Balvinder123x/ivflow-pcb/docs/stage4_render_top.png

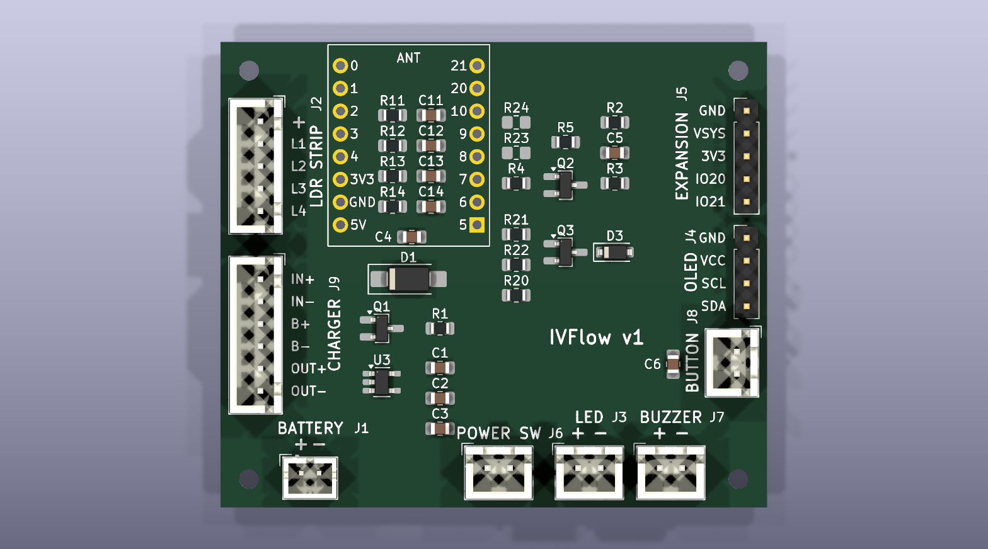
docs/stage4_render_top.png
