Balvinder123x/ivflow-pcb/docs/compact_render_top.png

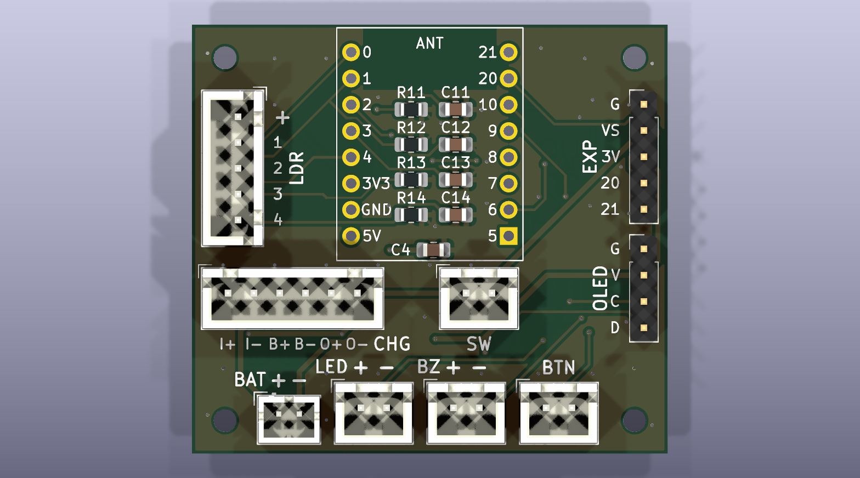
docs/compact_render_top.png
