Balvinder123x/ivflow-pcb/PROGRESS.md

# IVFlow PCB — Progress

## Environment (checked 2026-10-31)
| Item | Found |
|---|---|
| KiCad | 10.0.8, `C:\Program Files\KiCad\10.0` |
| kicad-cli | `C:\Program Files\KiCad\10.0\bin\kicad-cli.exe` (not on PATH; scripts use full path) |
| KiCad Python | `C:\Program Files\KiCad\10.0\bin\python.exe` — Python 3.11.5, `pcbnew` 10.0.8 |
| kiutils | 1.4.8, `pip --user` into KiCad's Python |
| git | 2.56.0, `C:\Program Files\Git\cmd\git.exe`; repo identity Balvinder123x <balvinder23166@iiitd.ac.in> |
| Java | Temurin 21.0.13 JRE, `C:\Program Files\Eclipse Adoptium\jre-21.0.13.9-hotspot\bin\java.exe` |
| Freerouting | 2.5.0 official jar in `tools/freerouting/` (git-ignored), run on a portable Temurin 25.0.5 JRE in `tools/jre25/` (SHA-256 verified; the jar needs Java 25). The native `freerouting-cli` 2.5.0 build crashed (GraalVM serialization error) and was removed. |

### Tooling rules
kiutils 1.4.8 predates the KiCad 10 format and drops data when rewriting KiCad 10 files.
- Symbols: generated with kiutils, then normalised with `kicad-cli sym upgrade --force`.
- Footprints: generated with the `pcbnew` API (writes native KiCad 10 format directly).
- Never rewrite a file KiCad/the user has saved with kiutils.
- Schematic: generated by `scripts/make_schematic.py` with `scripts/kisexpr.py` (lossless
  S-expression reader/writer; official symbols are embedded flattened). The script verifies
  every pin against KiCad's exported netlist, then runs ERC.
- Previews: `kicad-cli sym/fp/sch export svg`, rasterised with headless Edge for checking.

### Library availability (official KiCad 10 libs)
All needed parts exist **except** `Transistor_FET:DMG2305UX` → Q1 = **AO3401A**.

## Design changes vs. original spec
- 2026-10-31: off-board parts plug in through connectors.
  - J_OLED: 1×4 male header, fixed order GND, VCC, SCL, SDA (jumper wires to module) → no custom part.
  - LED: D2 replaced by **J_LED** (JST-XH 2-pin, pin 1 = anode/+, pin 2 = cathode/−). R20 stays on board.
  - J_LDR unchanged (JST-XH 5-pin).
- 2026-11-01: power switch, buzzer and button also moved off-board (user decision):
  SW1 → **J6 POWER SW** (1 VSYS, 2 VSYS_SW, to a panel-mount switch ≥ 1 A),
  BZ1 → **J7 BUZZER** (1 + VSYS_SW, 2 − BUZ_N), SW2 → **J8 BUTTON** (1 BTN, 2 GND).
  All JST-XH 2-pin. D3 (flyback) and C6 (debounce) stay on the board.
  ⚠ J3/J6/J7/J8 are identical, so cables can be swapped. Most swaps are harmless, but the
  switch or button cable in J7 shorts VSYS_SW to GND through Q3 when the buzzer turns on,
  and the LED in J7 has no series resistor. User chose clear silkscreen labels (2026-11-01);
  a 3-pin keyed J6 is still possible if wanted.
- 2026-11-01: **TP4056 moved off-board** (user decision, so the PCB doesn't wait for the module
  to arrive; online pad layouts differ between sellers, lengths 22–29 mm). New **J9 CHARGER**,
  JST-XH 6-pin: 1 IN+ (VBUS), 2 IN− (GND), 3 B+ (BATT+), 4 B− (BATT−), 5 OUT+ (VBAT_P),
  6 OUT− (GND). U2 kept in schematic + BOM, `on_board no`, no footprint. The TP4056
  placeholder footprint was deleted. The user solders a 6-pin XH cable to the module's pads.
  Current through J9 ≤ ~1.3 A (1 A charge + load); XH is rated 3 A.
- 2026-11-01: SuperMini footprint from **published dimensions** (user decision; no source gives
  the first-pin offset → pins centred). Check the real board on a 1:1 printout before ordering.
- Reference designators: KiCad treats references without a number as unannotated, so the
  spec's connector names map to numbered refs (the Value field carries the name):
  J1 = J_BAT (BATTERY), J2 = J_LDR (LDR STRIP), J3 = J_LED (LED), J4 = J_OLED (OLED),
  J5 = J_EXP (EXPANSION), J6 POWER SW, J7 BUZZER, J8 BUTTON, J9 CHARGER. Power flag = #FLG01.
- Net names used for internal nodes: LED_EN (GPIO5), BUZ_EN (GPIO6), BAT_EN (GPIO7), BTN (GPIO10),
  EXP_IO20/21, LED_A, BUZ_N (buzzer −), Q2_D, Q2_G, Q3_G, BATT+/BATT− (battery side of U2).

## Stages
- [x] **0. Environment + skeleton** — approved, committed
- [x] **1. Custom library** — approved 2026-11-02
  - `scripts/make_library.py` generates `ivflow/ivflow_lib/`
  - Symbol `ESP32-C3_SuperMini` ✔ — pin order **confirmed** from the user's board diagram (2026-10-31):
    top view, USB up: left row GPIO5,6,7,8,9,10,20,21 (pads 1-8); right row 5V, GND, 3V3,
    GPIO4,3,2,1,0 (pads 9-16). Antenna at the end opposite USB.
  - Footprint `ESP32-C3_SuperMini` — published dimensions 22.52 × 18 mm; row spacing 15.24 mm
    (also confirmed by the user's breadboard count); USB-C overhang ~2 mm (user, in courtyard);
    pins assumed centred (no source gives the offset). Marked "PUBLISHED DIMS – check on arrival"
    on F.Fab. **Before ordering the PCB: print the board 1:1 and lay the real SuperMini on it.**
    Courtyard = the two socket strips only (module stands ~8.5 mm up, low SMD parts may sit
    underneath); antenna keepout also forbids footprints. Pin names 1.0 mm, centred (2026-11-02).
  - Symbol `TP4056_Module_USB-C` ✔ (pads 1 IN+, 2 IN−, 3 BAT+, 4 BAT−, 5 OUT+, 6 OUT−), no
    footprint (module is off-board on J9).
- [x] **2. Schematic + ERC** — approved 2026-11-01 (connector polarities checked by the user)
  - One A4 sheet, blocks: Power, MCU, Battery sense, Sensors, LED, Buzzer, OLED/Button/Expansion
  - Netlist check: all 116 pin connections match the spec (with J9, 2026-11-01)
  - ERC: 0 errors, 0 warnings
- [x] **3. Footprints + BOM** — approved 2026-11-02
  - Footprints + `LCSC` field set per part in `scripts/make_schematic.py` (schematic regenerated;
    it had not been edited in KiCad). Hand-soldering pad variants for 0805 / SOT-23 / SOT-23-5 / SMA.
  - Connectors: J1 JST-PH B2B-PH-K; J2 JST-XH B5B-XH-A; J3, J6, J7, J8 JST-XH B2B-XH-A;
    J9 JST-XH B6B-XH-A (C144397); J4, J5 2.54 mm pin headers.
  - `scripts/make_bom.py` → `ivflow/bom/ivflow_bom.csv` (26 lines, 41 parts, exported from the
    schematic by kicad-cli) and `ivflow/bom/ivflow_offboard.csv` (things plugged into connectors,
    housings, hardware). Re-run it after any schematic edit.
  - All LCSC numbers checked against lcsc.com product pages. No number for J4/J5 (generic headers),
    U1/U2 (modules).
  - Footprint check: every on-board part has an existing footprint.
  - ERC: 0 errors, 0 warnings.
  - From Stage 4 on, symbol UUIDs link schematic ↔ board: the schematic must NOT be regenerated
    after the board is populated — targeted edits only.
  - Connector silkscreen labels defined in `scripts/silk_labels.py` (title naming the part that
    plugs in + a label per pin, "+"/"−" drawn large). Added to each footprint in Stage 4 so they
    move with the connector. Preview: `docs/connector_labels.png`.
- [x] **4. Outline, holes, placement** — approved 2026-11-02
  - `scripts/make_board.py` builds `ivflow.kicad_pcb` from kicad-cli's netlist export of the
    schematic (footprints, values, nets, symbol UUID links, fields). Placement table `PLACE`
    in the script. Refuses to overwrite a populated board without `--force`.
  - Board 61 × 52 mm, 4 × M2 holes (MountingHole_2.2mm_M2, NPTH) 3.2 mm from the corners,
    "IVFlow v1" on silk. Connector labels from `scripts/silk_labels.py` (reference printed
    after each title).
  - U1 turned 180°: antenna at the top edge over its keepout; USB-C points into the board and
    the strip below it holds only SMD parts, so a cable still fits with the module plugged in.
  - Under the module: LDR filters R11–R14/C11–C14 next to GPIO0–4, and C4.
  - Rules in `ivflow.kicad_pro` (JLCPCB 2-layer): clearance/track min 0.127, via min
    0.5/0.3, copper-to-edge 0.3, hole-to-hole 0.5, silk text ≥ 1.0/0.15 mm. Net classes:
    Default 0.25 mm, Power 0.5 mm (VBUS, VBAT_P, VSYS, VSYS_SW, +3V3, BATT+, BATT−).
  - DRC (`--schematic-parity`): 0 violations, 0 footprint errors, 84 unconnected pads
    (expected: no tracks until Stage 5). ERC still 0/0.
  - Previews: `docs/stage4_render_top.png` (3D), `docs/stage4_placement.png` (ratsnest).
  - From now on the board and schematic are linked by UUID: no regeneration of either,
    targeted edits only (once the user edits the board in KiCad).
- [x] **5. Routing + pours + DRC** — approved 2026-11-03
  - `scripts/route_board.py`: Specctra DSN export → Freerouting (100 passes max) → session
    import → GND zones on F.Cu and B.Cu (clearance 0.3, min width 0.25, thermal reliefs) →
    94 GND stitching vias on a 5 mm grid, each placed only where both pours are solid → refill.
  - Freerouting: 84 nets, 100 % routed in 3 passes, 0 violations. 14 signal vias.
  - Widths: power nets 0.5 mm (necked to 0.375 mm only at SOT-23 pads), signals 0.25 mm
    (0.187 mm at a few pin escapes). All above JLCPCB's 0.127 mm.
  - Antenna area checked: no copper fill, tracks or vias on either layer.
  - DRC (`--schematic-parity`): **0 violations, 0 unconnected pads, 0 footprint errors**.
    ERC 0/0.
  - Previews: `docs/stage5_routing_front.png`, `docs/stage5_routing_back.png` (tracks without
    pour), `docs/stage5_render_top.png`, `docs/stage5_render_bottom.png`.
- [ ] **6. Fab outputs** — done, 🛑 waiting for review (2026-11-03)
  - `scripts/make_fab.py` → `fab/` (see `fab/README.md`). Runs ERC + DRC first and stops
    unless both are clean (ERC 0/0, DRC 0 violations / 0 unconnected / 0 footprint errors).
  - Gerbers: F/B Cu, Paste, Silkscreen, Mask, Edge.Cuts; Protel extensions, no X2, soldermask
    subtracted from silk. Drill: Excellon mm, PTH and NPTH separate, Gerber X2 drill maps.
    Zipped as `fab/ivflow_gerbers_jlcpcb.zip` (14 files). Job file: 61.1 × 52.1 mm, 2 layers, 1.6 mm.
  - BOM: JLCPCB format (24 lines, DNP + off-board excluded) and full BOM (26 lines).
  - CPL: 38 parts (JLCPCB rotations not corrected; only matters for JLCPCB assembly).
  - Schematic PDF, 1:1 assembly drawing PDF, 3D renders top/bottom.
  - **Before ordering:** print the 1:1 PDF at 100 % and check the real SuperMini.
- [ ] **v1 compact revision** — done, 🛑 waiting for review (2026-11-05)
  - User request: smallest possible board, short recognisable labels.
  - R23/R24 (DNP I2C pull-ups) removed from the schematic (OLED module has them). Netlist
    check 112/112, ERC 0/0. C11–C14, C4 and J5 kept (user choice).
  - Board **46 × 41.5 mm** (was 61 × 52, −40 % area), parts on both sides (user choice):
    top = SuperMini, all connectors, LDR filters + C4 under the module; bottom = power path +
    regulator (strip between the two connector rows), battery sense (under the module),
    button cap / buzzer driver / LED resistor (right of the module). 4 × M2 corner holes kept.
  - The USB-C plug path under the SuperMini is no longer kept free (connectors sit below it):
    lift the module off its sockets to program it over USB.
  - Silk labels: one short name + pin marks per connector — BAT + −, LDR + 1 2 3 4, LED + −,
    BZ + −, BTN, SW, CHG I+ I− B+ B− O+ O−, OLED G V C D, EXP G VS 3V 20 21. J-numbers moved
    to the fab layer (assembly drawing). "IVFlow v1" on the bottom silk.
  - Rule `min_resolved_spokes` = 1 (two crowded THT GND pins get one thermal spoke on top; they
    also join the bottom pour).
  - Routed with Freerouting, GND pours + stitching vias. DRC 0 violations / 0 unconnected /
    0 footprint errors. Fab outputs regenerated.
  - Script fixes: footprints are loaded through one explicit PCB_IO plugin, and old items are
    removed with `board.Delete()` (`Remove()` broke pcbnew's SWIG types).
- [ ] **Enclosure v1** (Fusion 360, `mech/fusion_enclosure.py`), 2026-11-05: first working
  layout, 0 interferences. Problem found: the LED/LDR pockets faced closed wiring bays, so
  they could not be fitted. Superseded by v2.
- [ ] **Enclosure v2** — done, 🛑 waiting for review (2026-11-05)
  - `mech/fusion_enclosure_v2.py` builds the Fusion document "IVFlow enclosure v2" through
    `scripts/fusion_mcp.py` (direct HTTP to Fusion's MCP add-in; the VS Code extension does
    not load the server). Save the document in Fusion by hand (Ctrl+S).
  - Style from the user's inspiration: 54 × 146 mm, soft rounded front (R12, 3 mm edges),
    full smoked-acrylic face with the OLED behind it, flat-bottom notch at the top where the
    spike cap sits. User choices: no knob, no status LED, sensing zone closed (cap visible only).
  - Parts: black chassis (front + sensor head, one print: everything mounts in it), white back
    shell (4 × M2 through the PCB holes), black hinged door, 2 black side covers, 2 mm acrylic.
  - LED and LDRs go in **from the outside**: side recesses with flush covers, wire holes from
    the recesses down to the PCB. LDR slit now centred on the chamber axis (channel front is a
    U with 3.5 mm chamfers; the side foam centres the chamber).
  - TP4056 moved to the middle behind the battery (USB-C hole in the flat part of the bottom),
    battery 4 mm higher and PCB at z 36 because of the rounded bottom corners.
  - Check: 0 overlapping pairs among 56 bodies (incl. the real PCB STEP).
  - Pictures: `docs/enclosure_v2_*.png`.
  - Door lock + light seal (2026-11-05): snap latch on the free edge (flexible arm in a flush
    track on the right side, barb clicks into a notch, finger scoop to release; print the door
    in PETG, arm strain ~1.2 %), magnets kept. Light seal: tongue into the channel and into
    the backs of the fork and tube slots (right edges tapered for the swing), groove for black
    foam gasket tape beside the tongue. Swing test 0-90 deg: no collision except the barb's
    click at 1-2 deg.
  - Colour identity (user decision): matte pearl white body + black glossy acrylic face.
    White plastic leaks light, so the light-tightness comes from thick walls (head sides
    14 mm), the black foam lining, the tongue labyrinth and the gasket.
  - **Black sensor insert** (user request, replaces the side covers): the head is a pearl white
    shell (2.4 mm sides, 1.5 mm top/floor) around a black-printed insert that holds the whole
    light path (channel, fork/tube slots, LED hole, slit, LDR pocket, door magnet, middle hinge
    knuckle). LED + LDRs are fitted and wired on the bench, lead spaces filled with black hot
    glue, wires run down grooves in the insert and through the shell floor to J2/J3; the insert
    slides in from the back and is held by 2 x M2 x 8 from below. Sides are now plain white.
    Checks: 0 overlaps (55 bodies), door swing 0-90 deg clear of shell and insert, insert slides
    out 40 mm without collision. Recommended: black flocking tape or foam on the channel walls.

## Power-path / safety review (2026-11-01)
TP4056 is only a charger; the board adds the rest:
- Load sharing: with USB present the system runs from VBUS through D1 and Q1 is off
  (gate = VBUS), so the TP4056 charges the battery only and terminates correctly. Without USB,
  R1 pulls Q1's gate low and the battery feeds VSYS through Q1.
- Battery protection: DW01A + 8205A on the module (over-discharge ~2.4 V, over-current, short);
  the board takes power from the protected OUT+/OUT−, and BAT− never touches GND.
- Firmware must add a low-battery shutdown (≈3.3–3.4 V via BAT_SENSE): DW01A's cut-off is too
  deep for Li-Po life, and AP2112K drops out below ≈3.5 V input at full load.

## Drop sensing notes (2026-11-03)
- Concept validated by DripOMeter (open-source, HardwareX 2022, PMC9418544): green LED + LDR
  voltage divider across the drip chamber, works in room light with a slit mask in the sensor
  holder, dynamic baseline (1 Hz low-pass) + threshold to detect each drop. Same as IVFlow.
- Tune on a breadboard before fixing values: R11–R14 (DripOMeter matched the series resistor to
  the LDR's dark resistance). If R11–R14 go large (100k–1M), reduce C11–C14 (1 nF or DNP):
  10 nF × large R would slow the signal further (the LDR itself already takes ~20–30 ms).
- Fallback if the dip is too weak: IR LED + phototransistors on the same J2/J3 (R20 → ~150 Ω).

## Open questions
None blocking. When the parts arrive (before ordering the PCB):
1. Print `fab/ivflow_assembly_top_1to1.pdf` at 100 % (outline must measure 61 × 52 mm) and
   check the SuperMini's pins line up with U1 (pins-centred assumption).
2. Check the battery plug is JST-PH 2.0 with red = pin 1, and the OLED pin order.

Resolved 2026-11-01: power switch → J6 connector; buzzer + button → J7/J8 connectors;
mis-plug risk handled with clear silk labels; repo pushed to
https://github.com/Balvinder123x/ivflow-pcb (remote `origin`, push after every stage commit).
