Balvinder123x/ivflow-pcb/docs/compact_render_bottom.png

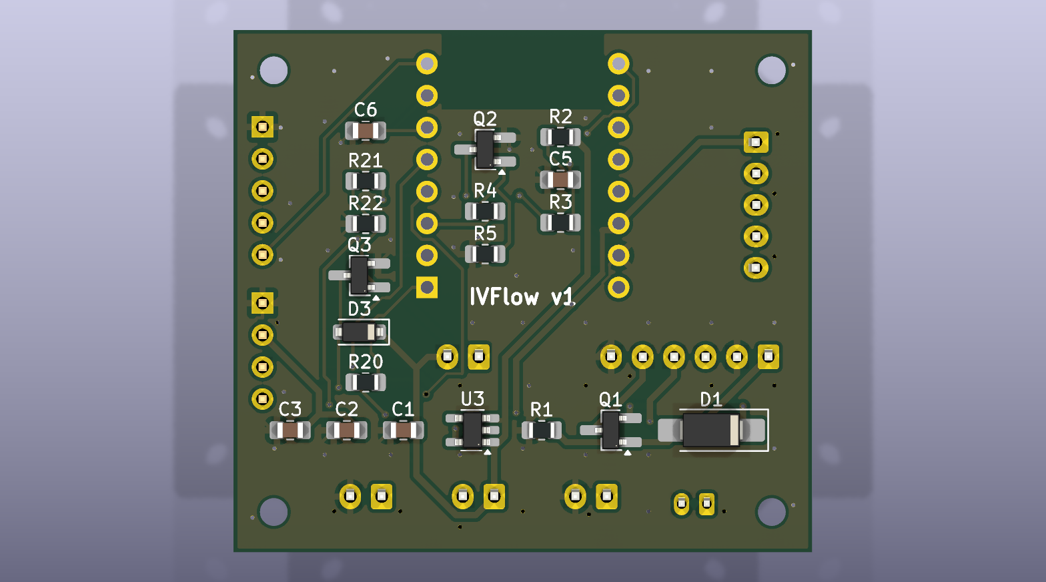
docs/compact_render_bottom.png
