Balvinder123x/ivflow-pcb/docs/connector_labels.png

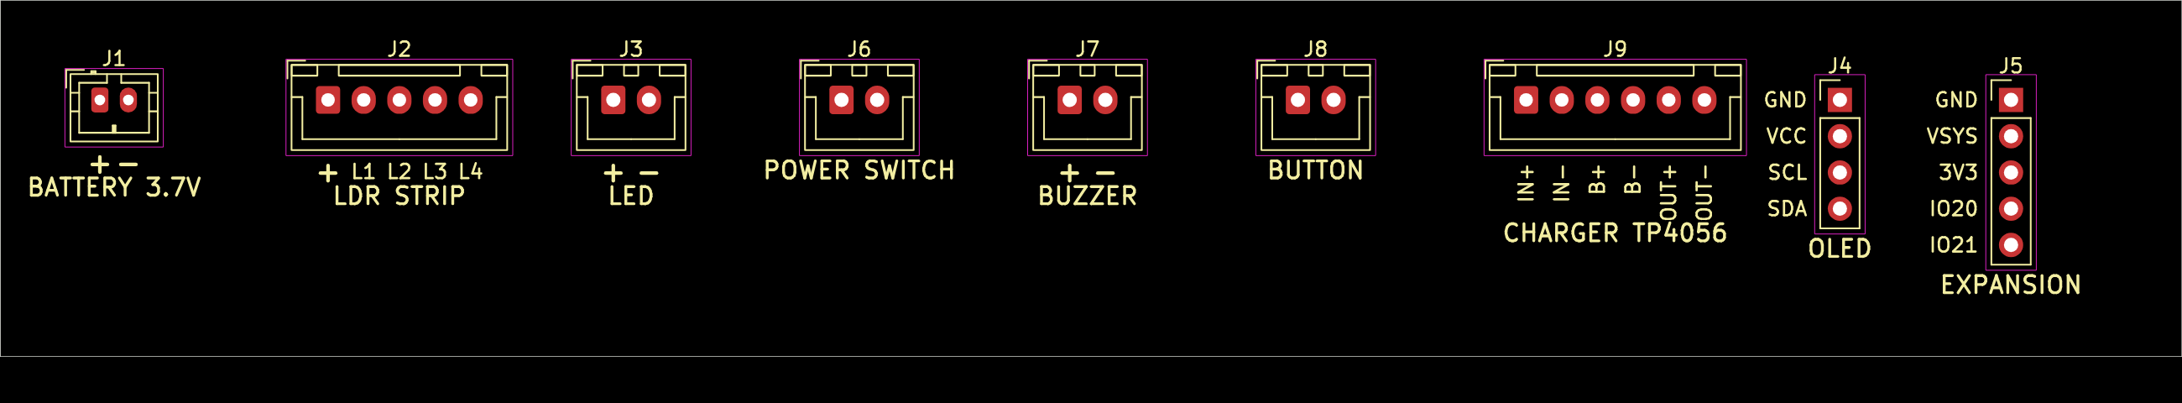
docs/connector_labels.png
