Balvinder123x/ivflow-pcb/docs/enclosure_v1_front.png

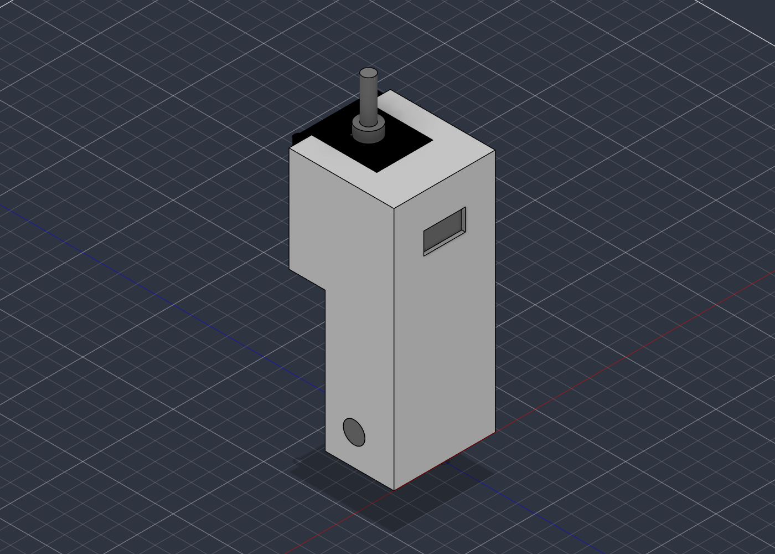
docs/enclosure_v1_front.png
