Balvinder123x/ivflow-pcb/docs/enclosure_v1_inside.png

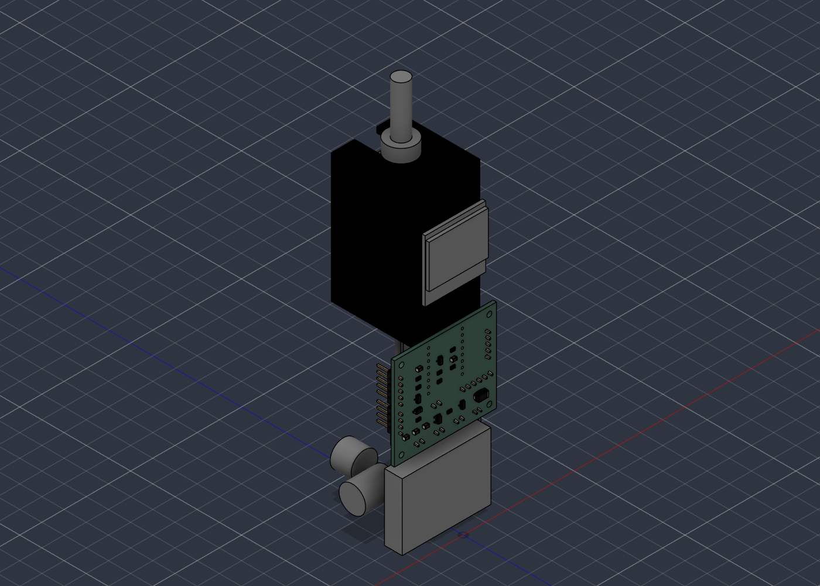
docs/enclosure_v1_inside.png
