Balvinder123x/ivflow-pcb/docs/enclosure_v1_side.png

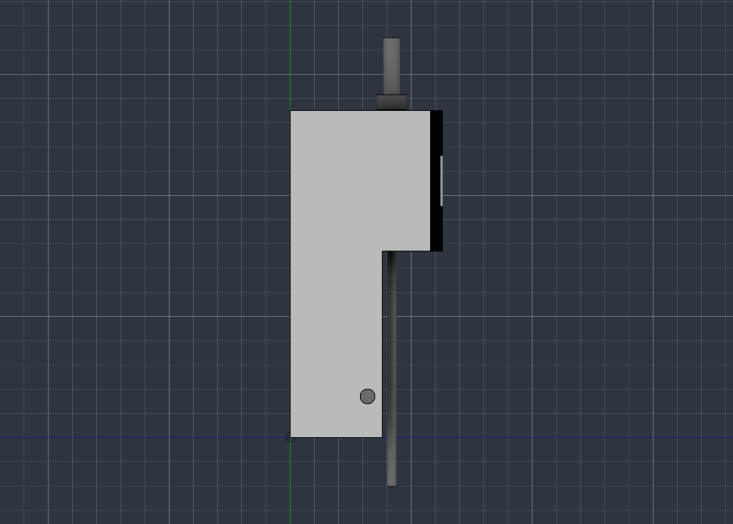
docs/enclosure_v1_side.png
