Balvinder123x/ivflow-pcb/docs/enclosure_v2_front.png

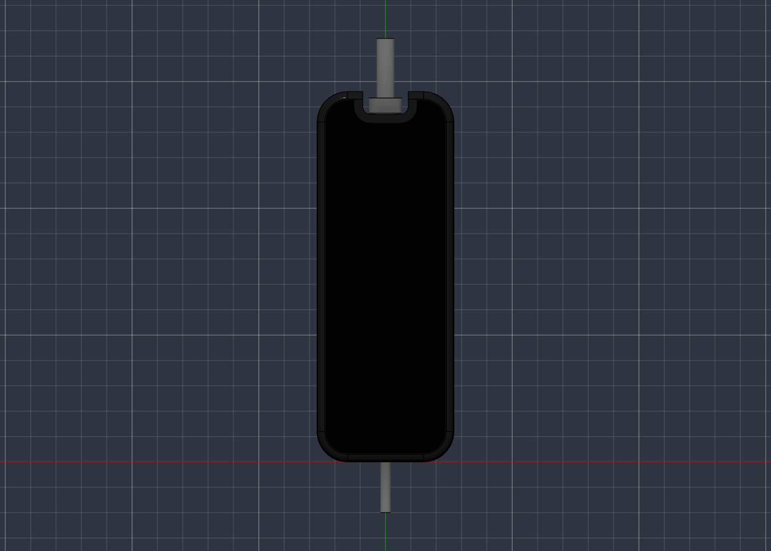
docs/enclosure_v2_front.png
