Balvinder123x/ivflow-pcb/docs/enclosure_v2_insert_alone.png

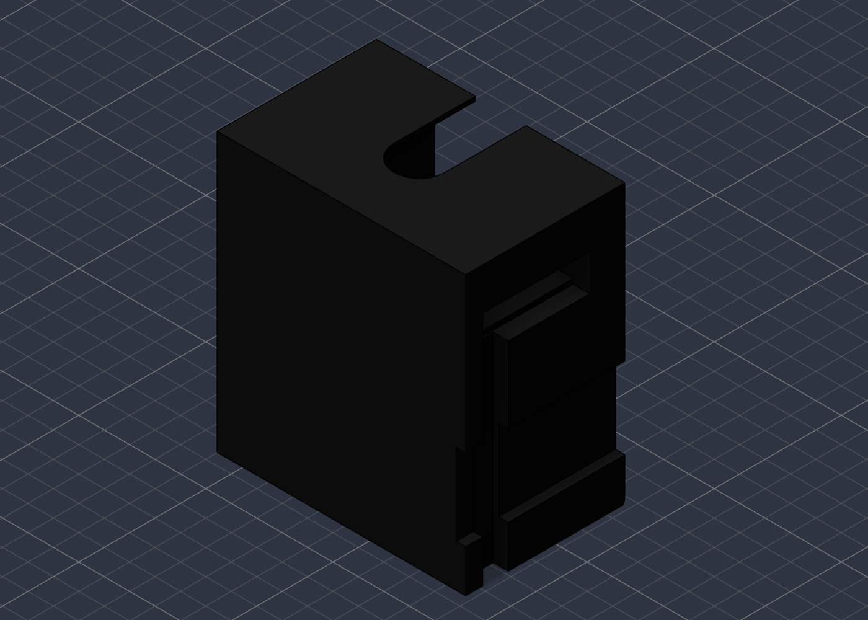
docs/enclosure_v2_insert_alone.png
