Balvinder123x/ivflow-pcb/docs/enclosure_v2_insert_back_door_off.png

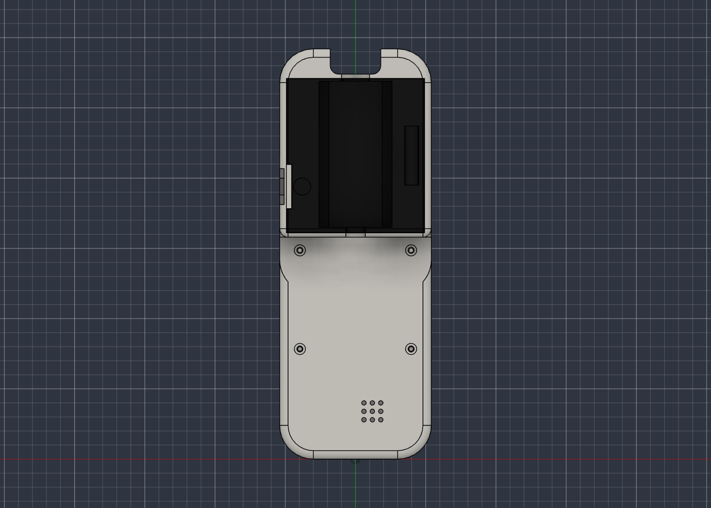
docs/enclosure_v2_insert_back_door_off.png
