Balvinder123x/ivflow-pcb/docs/enclosure_v2_inside_back.png

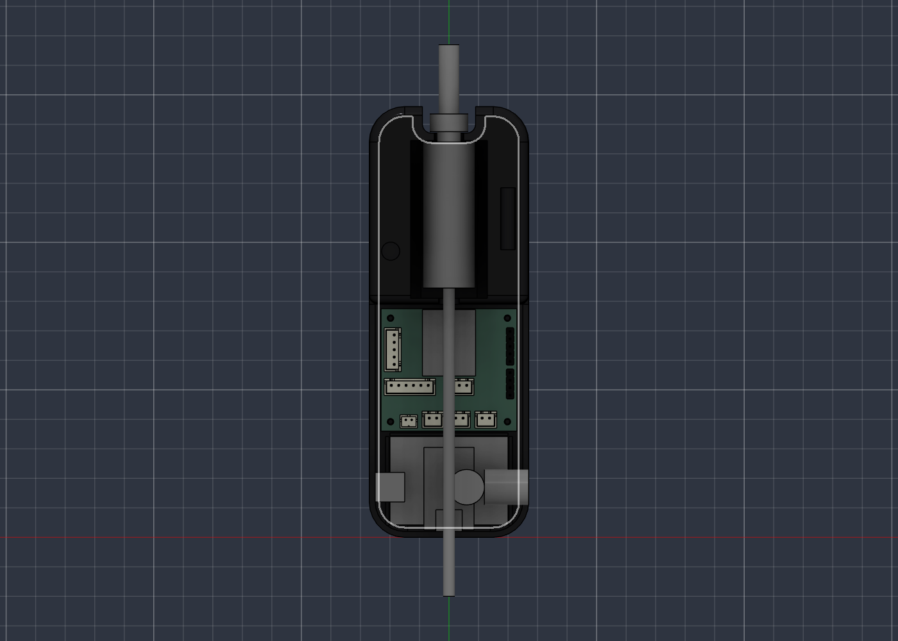
docs/enclosure_v2_inside_back.png
