Balvinder123x/ivflow-pcb/docs/enclosure_v2_iso.png

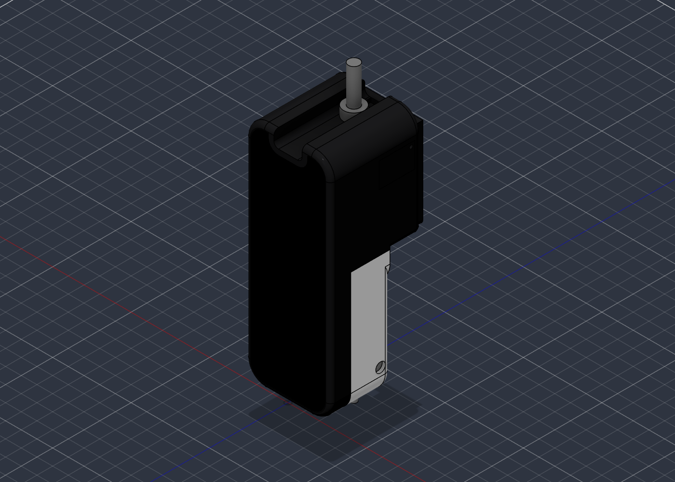
docs/enclosure_v2_iso.png
