Balvinder123x/ivflow-pcb/docs/enclosure_v2_pearl_iso.png

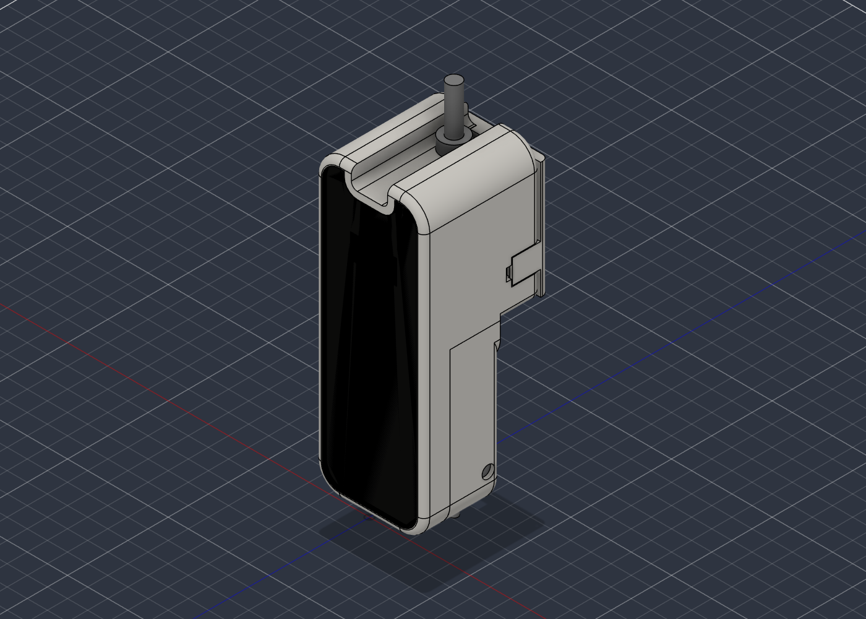
docs/enclosure_v2_pearl_iso.png
