Balvinder123x/ivflow-pcb/docs/stage4_placement.png

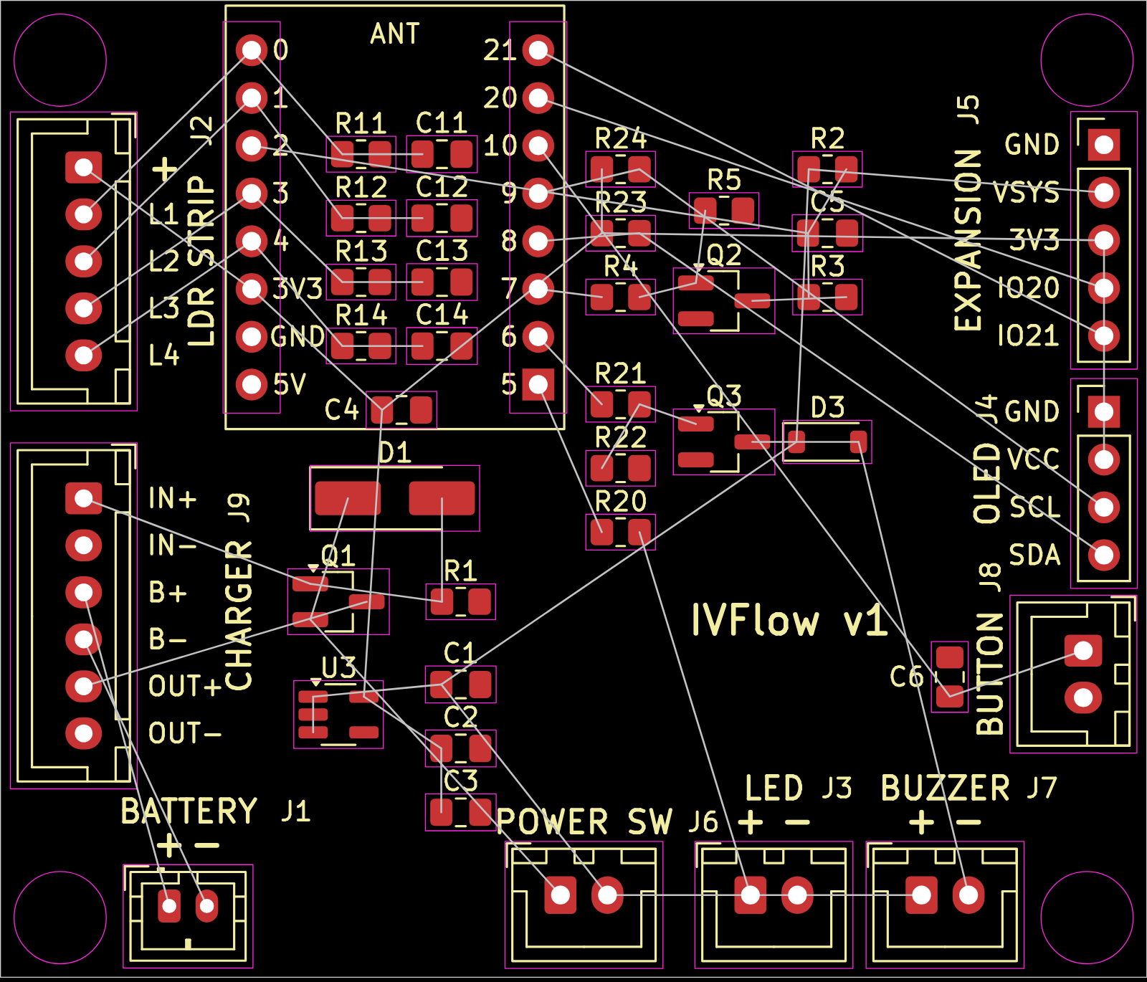
docs/stage4_placement.png
