Balvinder123x/ivflow-pcb/docs/stage5_render_bottom.png

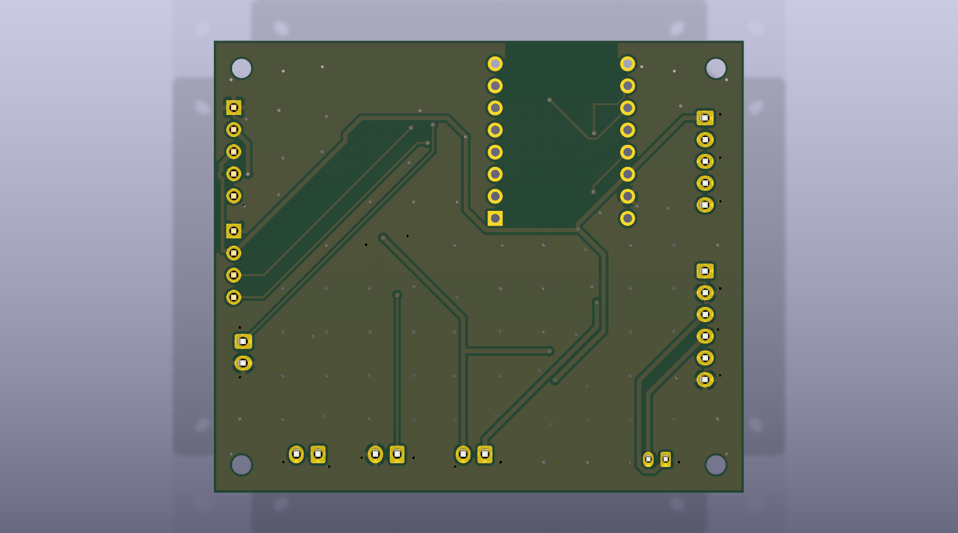
docs/stage5_render_bottom.png
