Balvinder123x/ivflow-pcb/docs/stage5_routing_back.png

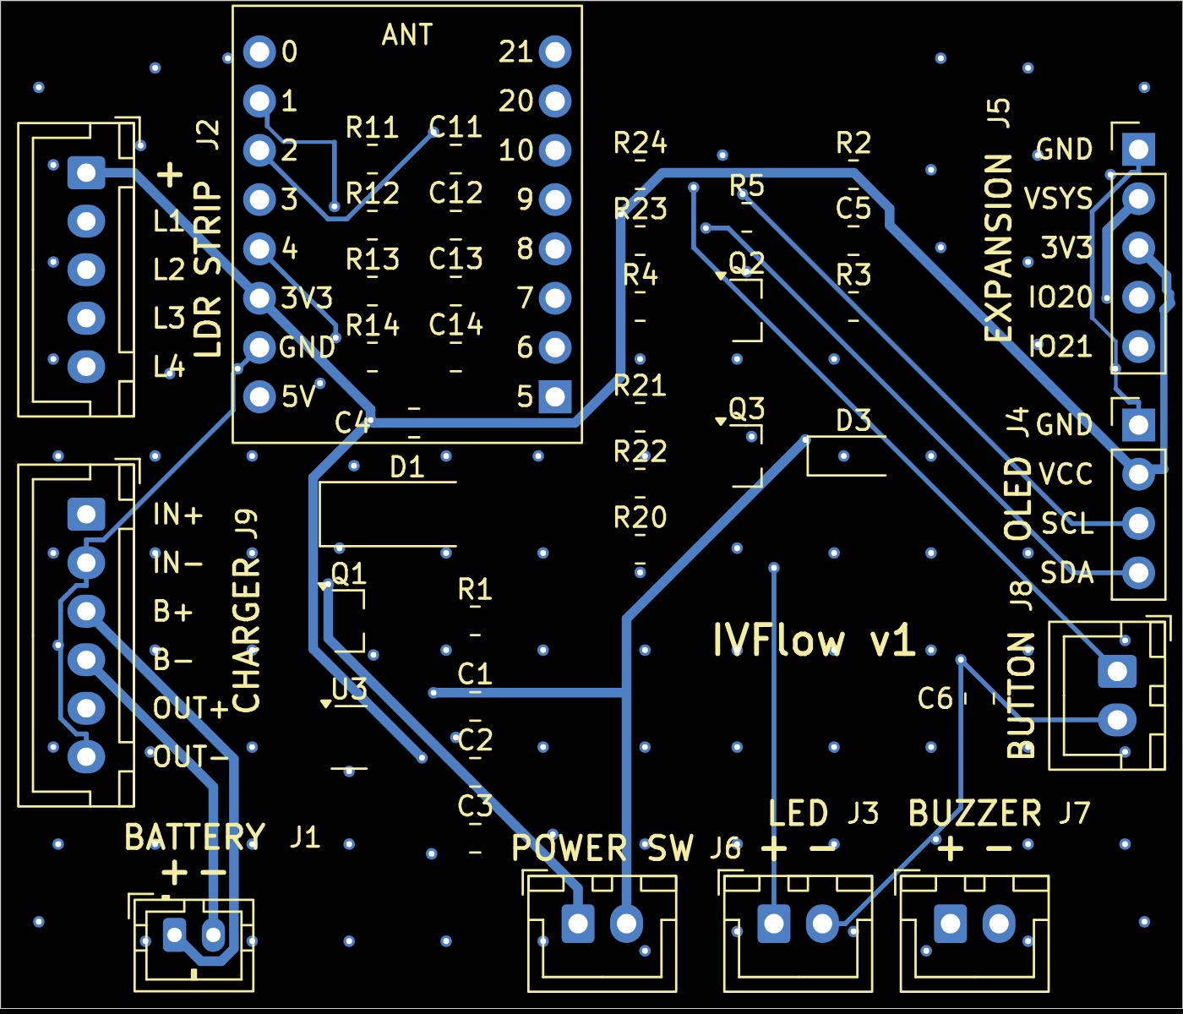
docs/stage5_routing_back.png
