Balvinder123x/ivflow-pcb/docs/stage5_routing_front.png

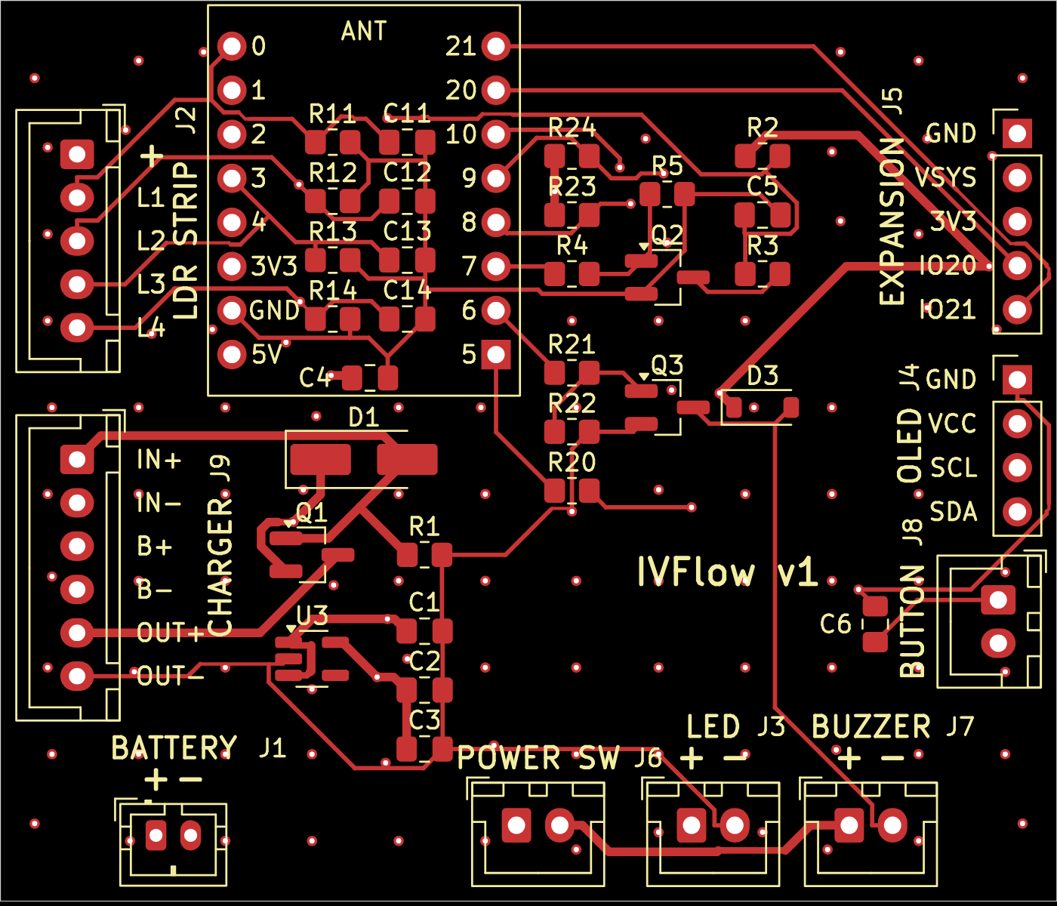
docs/stage5_routing_front.png
