Balvinder123x/ivflow-pcb/fab/ivflow_bom_full.csv

Value | Designator | Footprint | LCSC | Qty | DNP
10u | C1,C2 | Capacitor_SMD:C_0805_2012Metric_Pad1.18x1.45mm_HandSolder | C15850 | 2
100n | C3,C5,C6 | Capacitor_SMD:C_0805_2012Metric_Pad1.18x1.45mm_HandSolder | C49678 | 3
22u | C4 | Capacitor_SMD:C_0805_2012Metric_Pad1.18x1.45mm_HandSolder | C45783 | 1
10n | C11,C12,C13,C14 | Capacitor_SMD:C_0805_2012Metric_Pad1.18x1.45mm_HandSolder | C1710 | 4
SS14 | D1 | Diode_SMD:D_SMA_Handsoldering | C2480 | 1
1N4148W | D3 | Diode_SMD:D_SOD-123 | C81598 | 1
BATTERY | J1 | Connector_JST:JST_PH_B2B-PH-K_1x02_P2.00mm_Vertical | C131337 | 1
LDR STRIP | J2 | Connector_JST:JST_XH_B5B-XH-A_1x05_P2.50mm_Vertical | C157991 | 1
LED | J3 | Connector_JST:JST_XH_B2B-XH-A_1x02_P2.50mm_Vertical | C158012 | 1
OLED | J4 | Connector_PinHeader_2.54mm:PinHeader_1x04_P2.54mm_Vertical |  | 1
EXPANSION | J5 | Connector_PinHeader_2.54mm:PinHeader_1x05_P2.54mm_Vertical |  | 1
POWER SW | J6 | Connector_JST:JST_XH_B2B-XH-A_1x02_P2.50mm_Vertical | C158012 | 1
BUZZER | J7 | Connector_JST:JST_XH_B2B-XH-A_1x02_P2.50mm_Vertical | C158012 | 1
BUTTON | J8 | Connector_JST:JST_XH_B2B-XH-A_1x02_P2.50mm_Vertical | C158012 | 1
CHARGER | J9 | Connector_JST:JST_XH_B6B-XH-A_1x06_P2.50mm_Vertical | C144397 | 1
AO3401A | Q1 | Package_TO_SOT_SMD:SOT-23_Handsoldering | C15127 | 1
2N7002 | Q2 | Package_TO_SOT_SMD:SOT-23_Handsoldering | C8545 | 1
AO3400A | Q3 | Package_TO_SOT_SMD:SOT-23_Handsoldering | C20917 | 1
100k | R1,R2,R3,R5,R22 | Resistor_SMD:R_0805_2012Metric_Pad1.20x1.40mm_HandSolder | C149504 | 5
100 | R4,R21 | Resistor_SMD:R_0805_2012Metric_Pad1.20x1.40mm_HandSolder | C17408 | 2
10k | R11,R12,R13,R14 | Resistor_SMD:R_0805_2012Metric_Pad1.20x1.40mm_HandSolder | C17414 | 4
82 | R20 | Resistor_SMD:R_0805_2012Metric_Pad1.20x1.40mm_HandSolder | C17841 | 1
ESP32-C3 SuperMini | U1 | ivflow_lib:ESP32-C3_SuperMini |  | 1
TP4056 USB-C (off-board) | U2 |  |  | 1
AP2112K-3.3 | U3 | Package_TO_SOT_SMD:SOT-23-5_HandSoldering | C51118 | 1
