Balvinder123x/ivflow-pcb/mech/export/ivflow_enclosure_v2_assembly.step

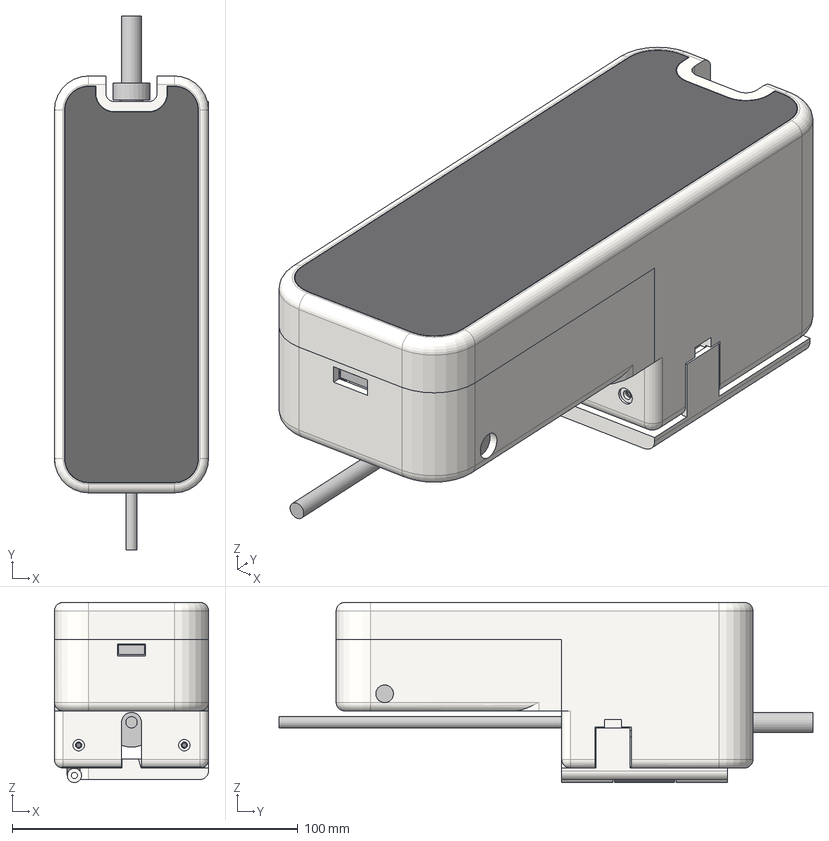
[picture p19: CAD file, 2026-11-05]
mech/export/ivflow_enclosure_v2_assembly.step
54.0 x 187.0 x 63.1 mm
C_0805_2012Metric_1 x 10
R_0805_2012Metric_1 x 12
JST_B6B_XH_A
PinHeader_1x05_P254mm_Vertical
PinHeader_1x04_P254mm_Vertical
JST_B2B_XH_A x 4
JST_B5B_XH_A
JST_B2B_PH_K
D_SOD-123_1
D_SMA_1
SOT-23_1 x 3
SOT-23-5_1
ivflow_PCB
