Balvinder123x/ivflow-pcb/mech/export/ivflow_chassis_pearl_white.stl

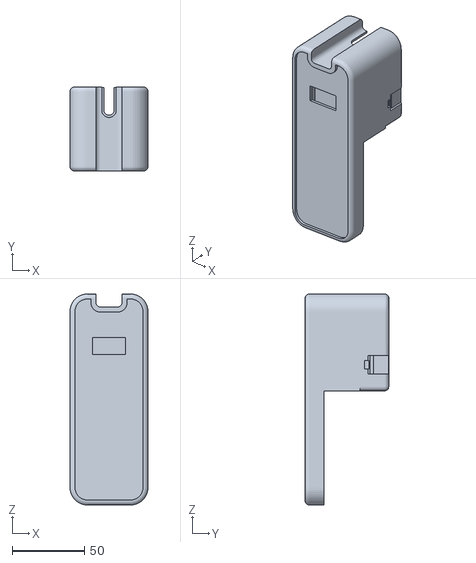
[picture p20: CAD file, 2026-11-05]
mech/export/ivflow_chassis_pearl_white.stl
54.0 x 58.0 x 146.0
