Balvinder123x/ivflow-pcb/mech/ivflow_pcb.step

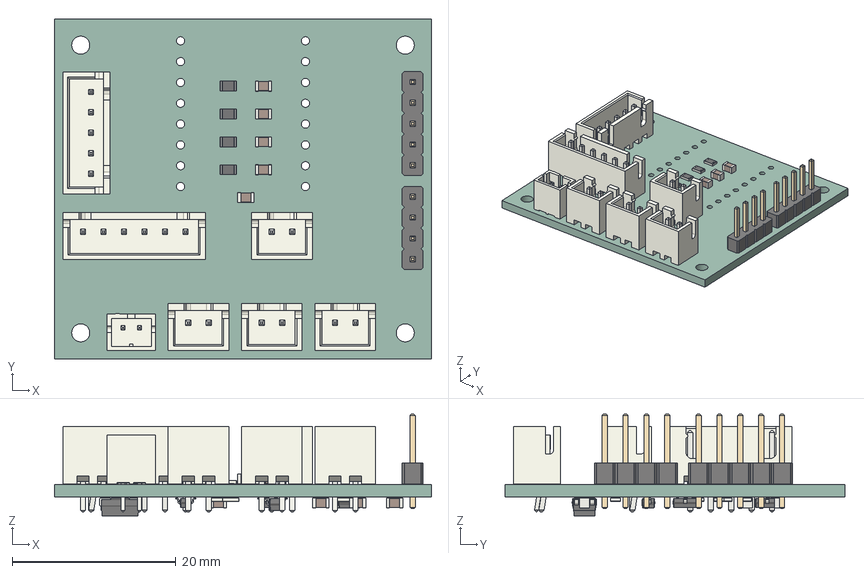
[picture p21: CAD file, 2026-11-05]
mech/ivflow_pcb.step
46.0 x 41.5 x 12.4 mm
C_0805_2012Metric x 10
R_0805_2012Metric x 12
JST_B6B_XH_A
PinHeader_1x05_P254mm_Vertical
PinHeader_1x04_P254mm_Vertical
JST_B2B_XH_A x 4
JST_B5B_XH_A
JST_B2B_PH_K
D_SOD-123
D_SMA
SOT-23 x 3
SOT-23-5
ivflow_PCB
