Balvinder123x/ivflow-pcb/mech/export/ivflow_sensor_insert_black.stl

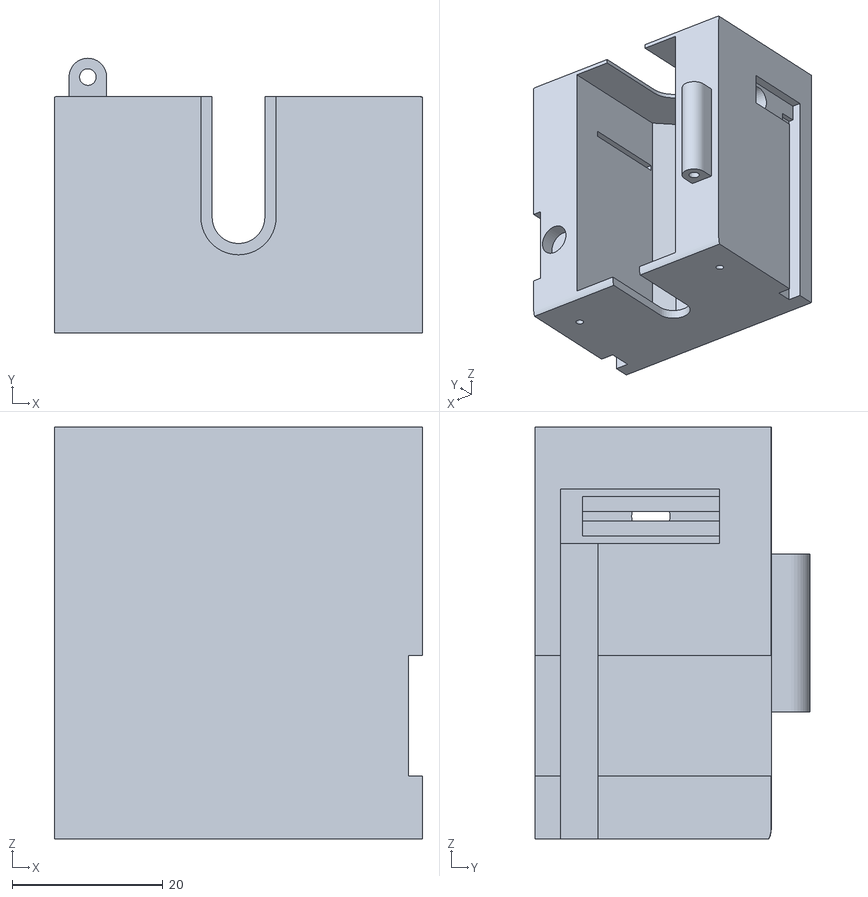
[picture p22: CAD file, 2026-11-05]
mech/export/ivflow_sensor_insert_black.stl
48.9 x 36.4 x 54.7
