Balvinder123x/ivflow-pcb/mech/export/ivflow_face_2mm_smoked_acrylic.dxf

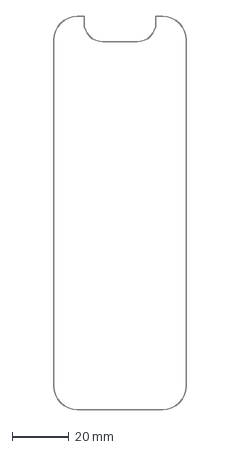
[picture p23: CAD file, 2026-11-05]
mech/export/ivflow_face_2mm_smoked_acrylic.dxf
46.7 x 138.7 mm
