Balvinder123x/ivflow-pcb/mech/export/ivflow_door_pearl_white_PETG.stl

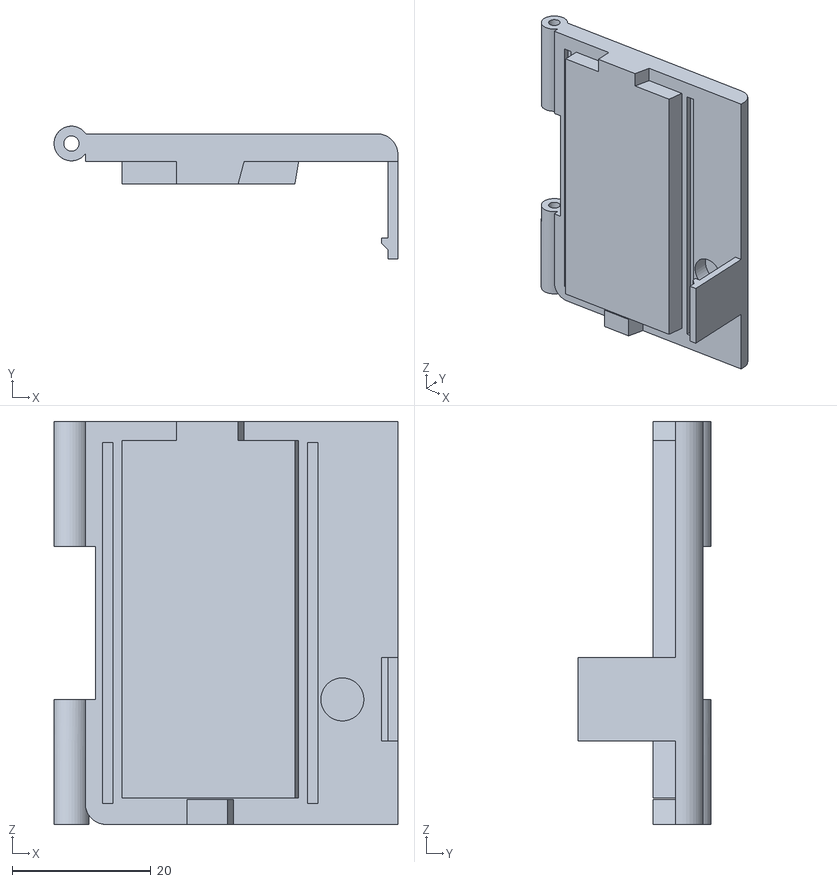
[picture p24: CAD file, 2026-11-05]
mech/export/ivflow_door_pearl_white_PETG.stl
49.5 x 19.1 x 58.0
