Balvinder123x/ivflow-pcb/mech/export/ivflow_back_shell_pearl_white.stl

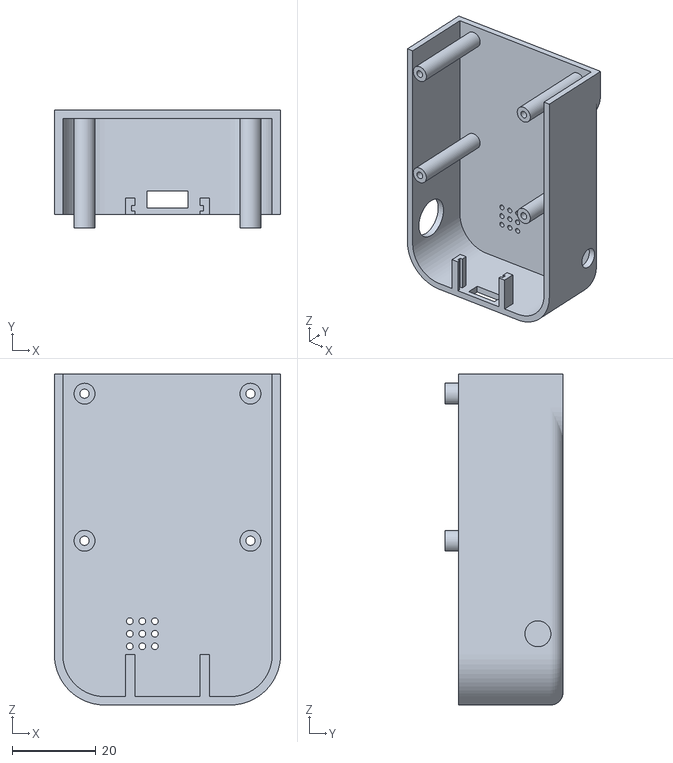
[picture p25: CAD file, 2026-11-05]
mech/export/ivflow_back_shell_pearl_white.stl
54.0 x 28.2 x 79.0
