Balvinder123x/ivflow-pcb/fab/ivflow_assembly_top_1to1.pdf

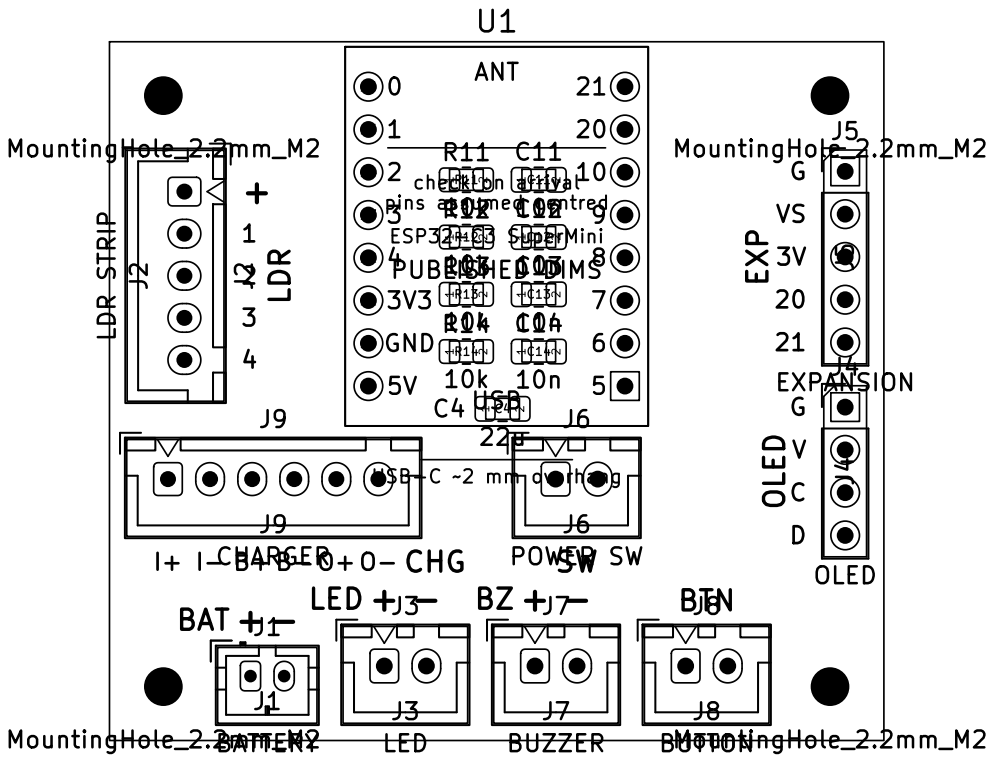
[picture p26: page 1]

Size: A4 | Rev: v1
KiCad E.D.A. 10.0.8 | Id: 1/1
