Balvinder123x/ivflow-pcb/fab/ivflow_schematic.pdf

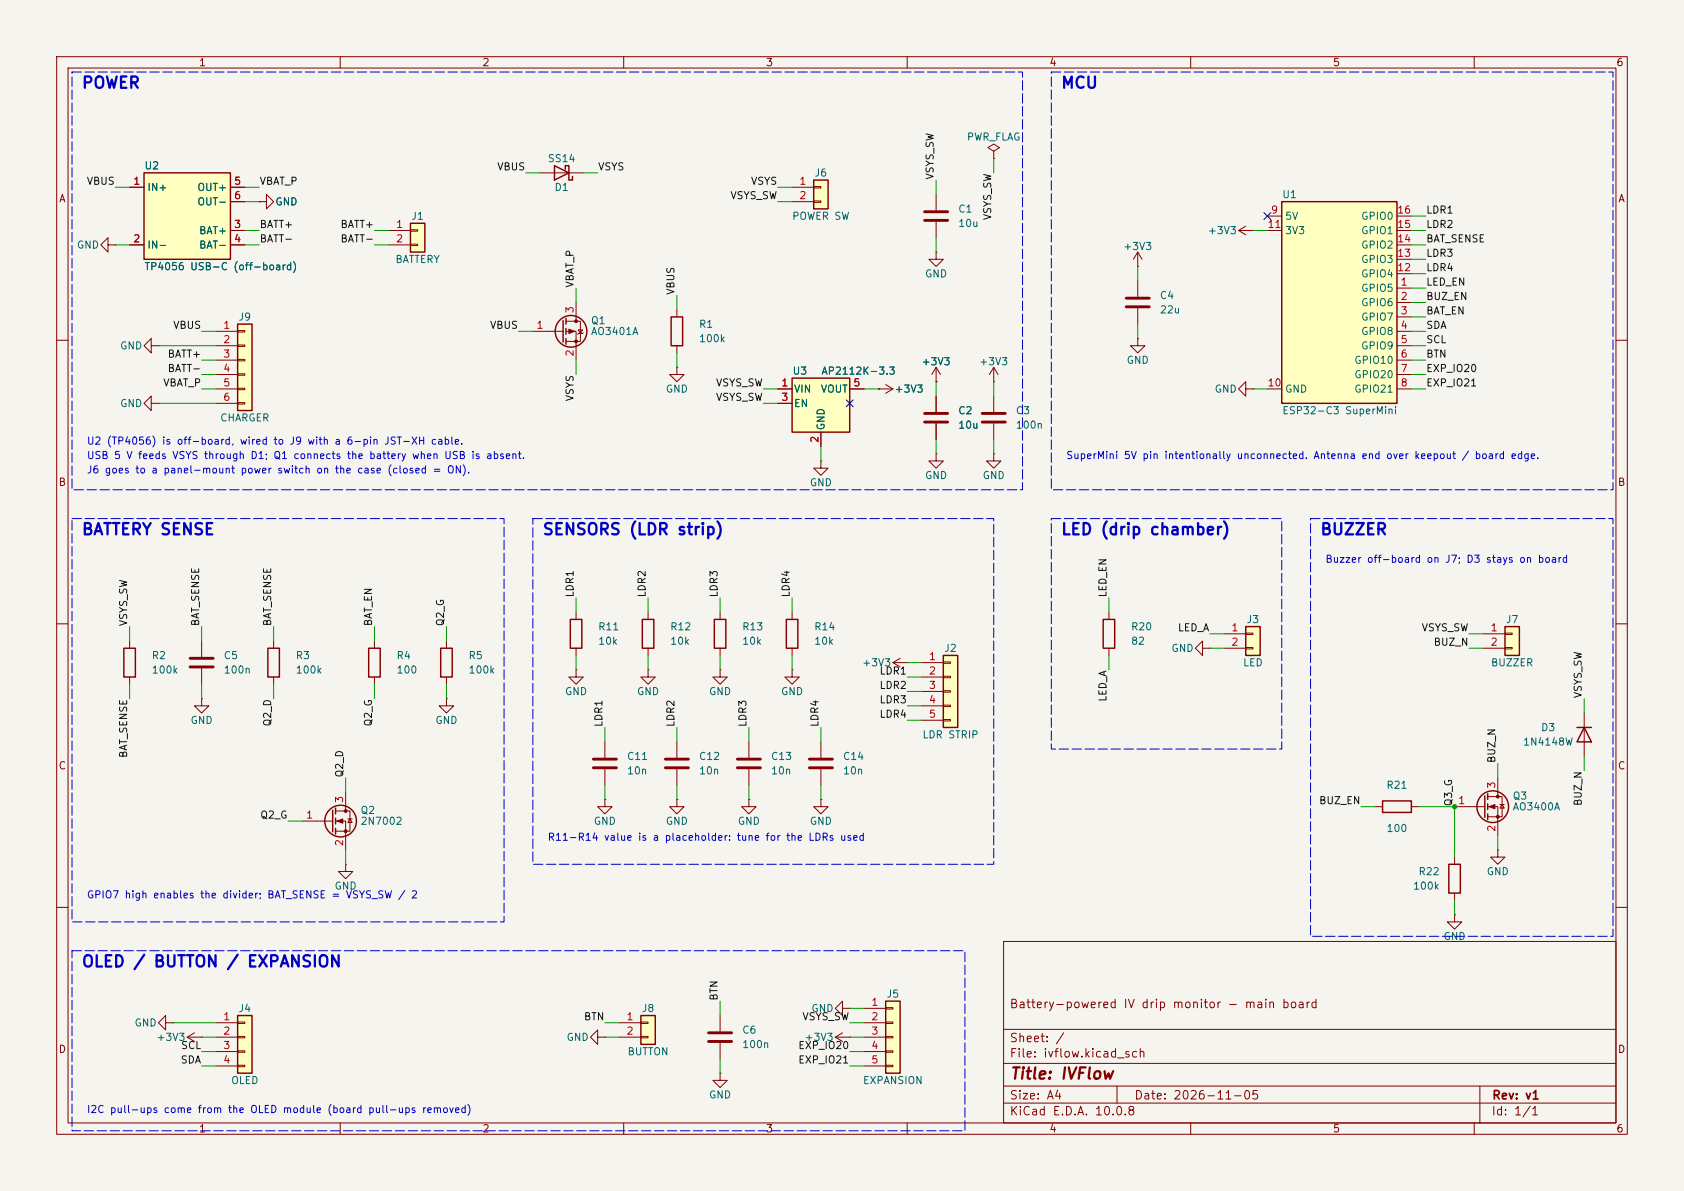
[picture p27: page 1]

R11-R14 value is a placeholder: tune for the LDRs used POWER

Buzzer off-board on J7; D3 stays on board MCU

U2 (TP4056) is off-board, wired to J9 with a 6-pin JST-XH cable. J6 goes to a panel-mount power switch on the case (closed = ON). USB 5 V feeds VSYS through D1; Q1 connects the battery when USB is absent. GPIO7 high enables the divider; BAT_SENSE = VSYS_SW / 2

SuperMini 5V pin intentionally unconnected. Antenna end over keepout / board edge.

Battery-powered IV drip monitor - main board

Size: A4 | Rev: v1
KiCad E.D.A. 10.0.8 | Id: 1/1

I2C pull-ups come from the OLED module (board pull-ups removed)
