Balvinder123x/ivflow-pcb/ivflow/ivflow.kicad_pcb

## KiCad design ivflow/ivflow.kicad_pcb (2026-11-05)

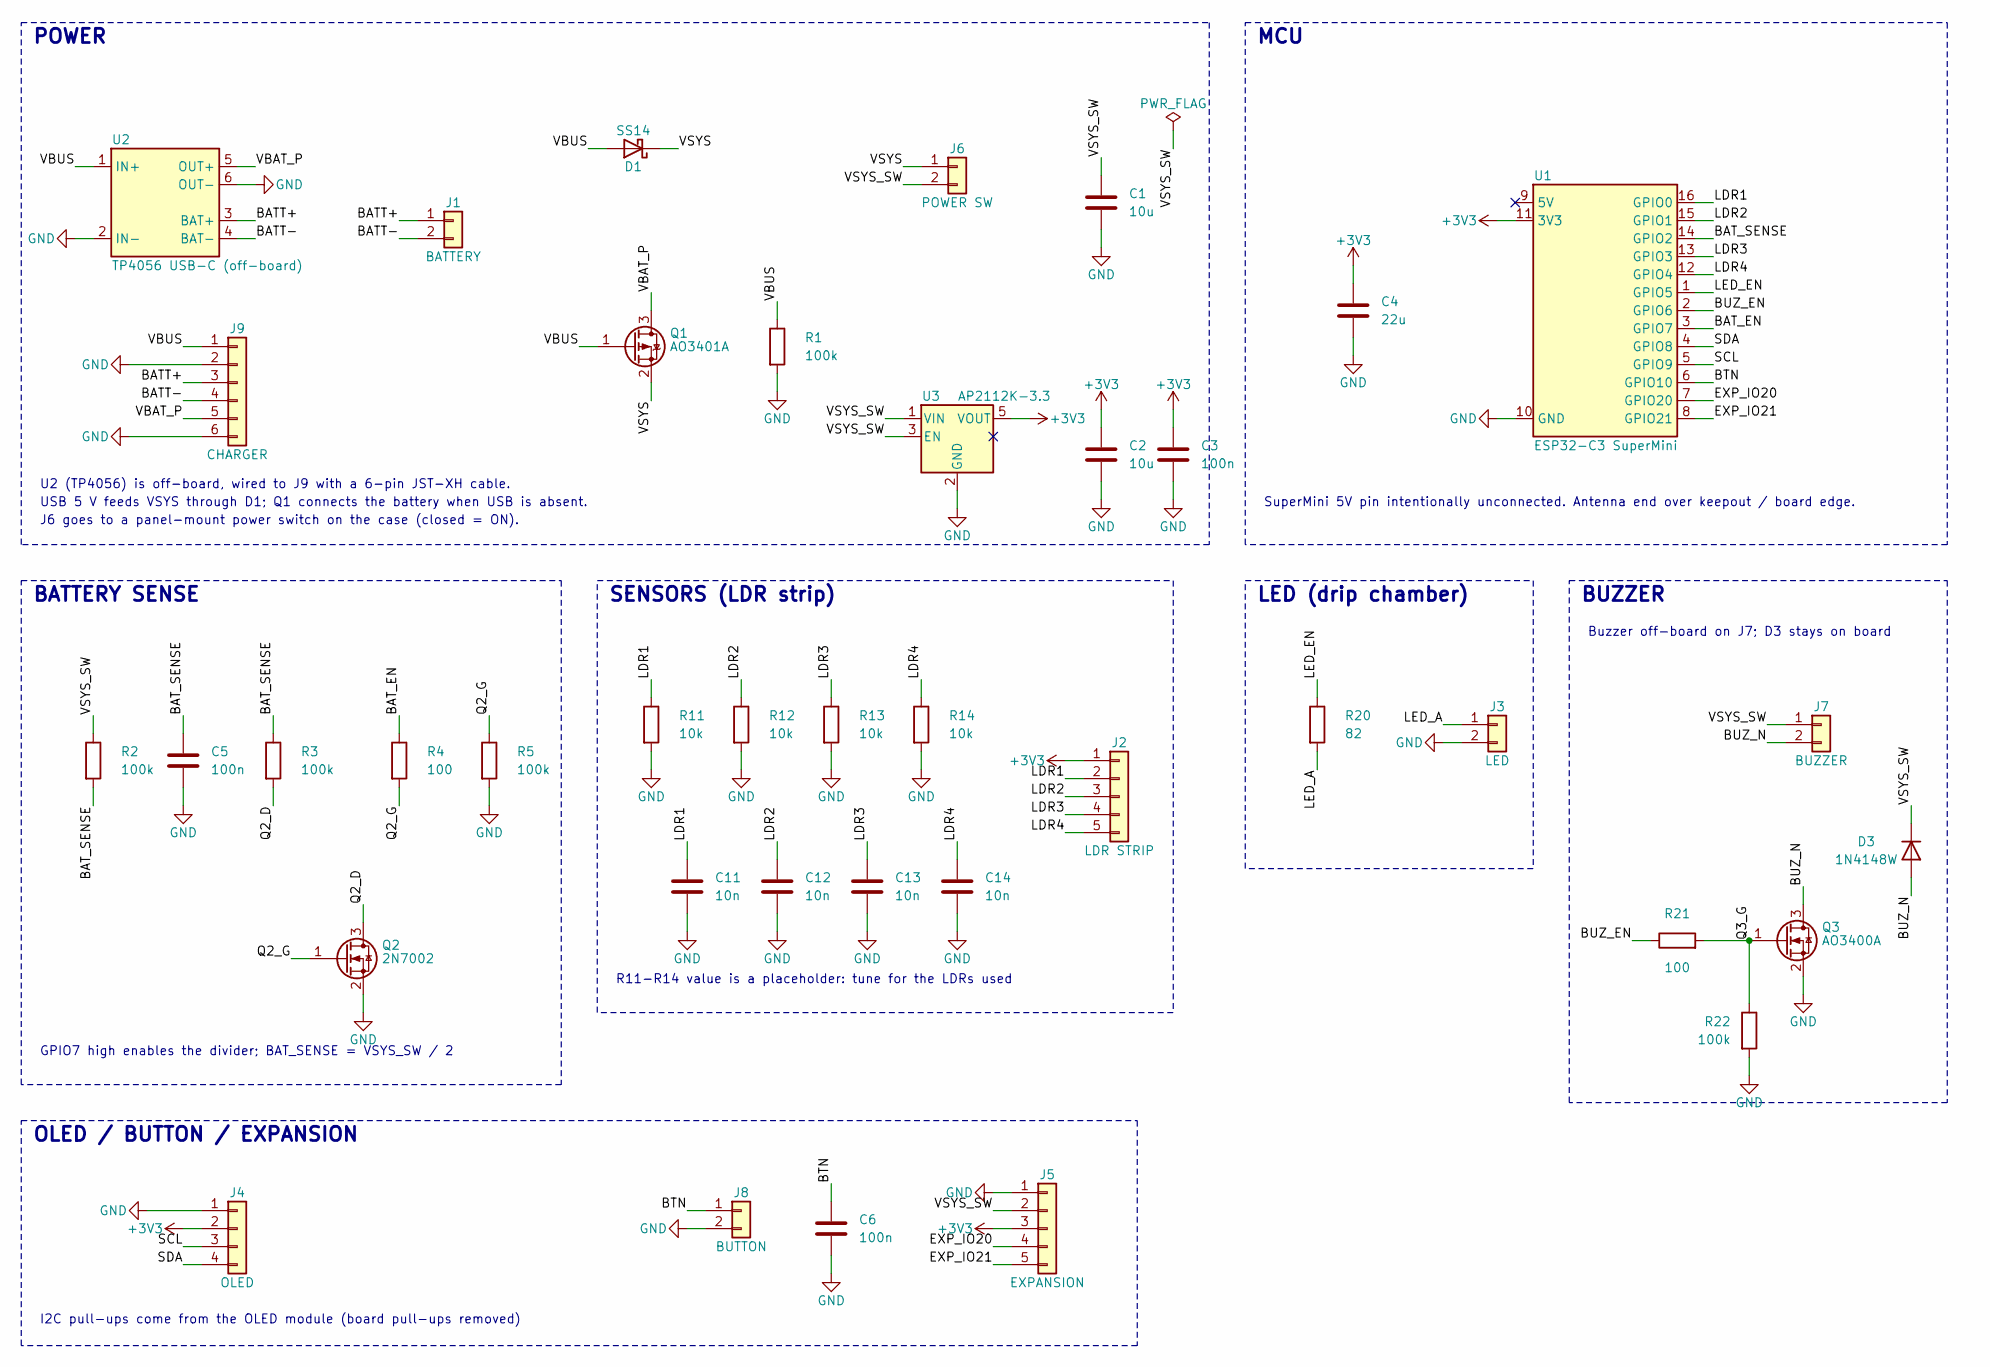
[picture p28: schematic ivflow.kicad_sch]

Parts:
C1, C2: 10u; C_0805_2012Metric_Pad1.18x1.45mm_HandSolder; LCSC C15850
C3, C5, C6: 100n; C_0805_2012Metric_Pad1.18x1.45mm_HandSolder; LCSC C49678
C4: 22u; C_0805_2012Metric_Pad1.18x1.45mm_HandSolder; LCSC C45783
C11, C12, C13, C14: 10n; C_0805_2012Metric_Pad1.18x1.45mm_HandSolder; LCSC C1710
D1: SS14; D_SMA_Handsoldering; LCSC C2480
D3: 1N4148W; D_SOD-123; LCSC C81598
J1: BATTERY; JST_PH_B2B-PH-K_1x02_P2.00mm_Vertical; LCSC C131337
J2: LDR STRIP; JST_XH_B5B-XH-A_1x05_P2.50mm_Vertical; LCSC C157991
J3: LED; JST_XH_B2B-XH-A_1x02_P2.50mm_Vertical; LCSC C158012
J4: OLED; PinHeader_1x04_P2.54mm_Vertical
J5: EXPANSION; PinHeader_1x05_P2.54mm_Vertical
J6: POWER SW; JST_XH_B2B-XH-A_1x02_P2.50mm_Vertical; LCSC C158012
J7: BUZZER; JST_XH_B2B-XH-A_1x02_P2.50mm_Vertical; LCSC C158012
J8: BUTTON; JST_XH_B2B-XH-A_1x02_P2.50mm_Vertical; LCSC C158012
J9: CHARGER; JST_XH_B6B-XH-A_1x06_P2.50mm_Vertical; LCSC C144397
Q1: AO3401A; SOT-23_Handsoldering; LCSC C15127
Q2: 2N7002; SOT-23_Handsoldering; LCSC C8545
Q3: AO3400A; SOT-23_Handsoldering; LCSC C20917
R1, R2, R3, R5, R22: 100k; R_0805_2012Metric_Pad1.20x1.40mm_HandSolder; LCSC C149504
R4, R21: 100; R_0805_2012Metric_Pad1.20x1.40mm_HandSolder; LCSC C17408
R11, R12, R13, R14: 10k; R_0805_2012Metric_Pad1.20x1.40mm_HandSolder; LCSC C17414
R20: 82; R_0805_2012Metric_Pad1.20x1.40mm_HandSolder; LCSC C17841
U1: ESP32-C3 SuperMini; ESP32-C3_SuperMini
U2: TP4056 USB-C (off-board)
U3: AP2112K-3.3; SOT-23-5_HandSoldering; LCSC C51118

Connections:
+3V3: C2.1, C3.1, C4.1, J2.1, J4.2, J5.3, U1.11 (3V3), U3.5 (VOUT)
/BATT+: J1.1, J9.3, U2.3 (BAT+)
/BATT-: J1.2, J9.4, U2.4 (BAT-)
/BAT_EN: R4.1, U1.3 (GPIO7)
/BAT_SENSE: C5.1, R2.2, R3.1, U1.14 (GPIO2)
/BTN: C6.1, J8.1, U1.6 (GPIO10)
/BUZ_EN: R21.1, U1.2 (GPIO6)
/BUZ_N: D3.2 (A), J7.2, Q3.3 (D)
/EXP_IO20: J5.4, U1.7 (GPIO20)
/EXP_IO21: J5.5, U1.8 (GPIO21)
/LDR1: C11.1, J2.2, R11.1, U1.16 (GPIO0)
/LDR2: C12.1, J2.3, R12.1, U1.15 (GPIO1)
/LDR3: C13.1, J2.4, R13.1, U1.13 (GPIO3)
/LDR4: C14.1, J2.5, R14.1, U1.12 (GPIO4)
/LED_A: J3.1, R20.2
/LED_EN: R20.1, U1.1 (GPIO5)
/Q2_D: Q2.3 (D), R3.2
/Q2_G: Q2.1 (G), R4.2, R5.1
/Q3_G: Q3.1 (G), R21.2, R22.1
/SCL: J4.3, U1.5 (GPIO9)
/SDA: J4.4, U1.4 (GPIO8)
/VBAT_P: J9.5, Q1.3 (D), U2.5 (OUT+)
/VBUS: D1.2 (A), J9.1, Q1.1 (G), R1.1, U2.1 (IN+)
/VSYS: D1.1 (K), J6.1, Q1.2 (S)
/VSYS_SW: C1.1, D3.1 (K), J5.2, J6.2, J7.1, R2.1, U3.1 (VIN), U3.3 (EN)
GND: C1.2, C2.2, C3.2, C4.2, C5.2, C6.2, C11.2, C12.2, C13.2, C14.2, J3.2, J4.1, J5.1, J8.2, J9.2, J9.6, Q2.2 (S), Q3.2 (S), R1.2, R5.2, R11.2, R12.2, R13.2, R14.2, R22.2, U1.10 (GND), U2.2 (IN-), U2.6 (OUT-), U3.2 (GND)

Notes on the sheet:
POWER
MCU
BATTERY SENSE
SENSORS (LDR strip)
LED (drip chamber)
BUZZER
OLED / BUTTON / EXPANSION
USB 5 V feeds VSYS through D1; Q1 connects the battery when USB is absent.
J6 goes to a panel-mount power switch on the case (closed = ON).
U2 (TP4056) is off-board, wired to J9 with a 6-pin JST-XH cable.
SuperMini 5V pin intentionally unconnected. Antenna end over keepout / board edge.
Buzzer off-board on J7; D3 stays on board
GPIO7 high enables the divider; BAT_SENSE = VSYS_SW / 2
R11-R14 value is a placeholder: tune for the LDRs used
I2C pull-ups come from the OLED module (board pull-ups removed)

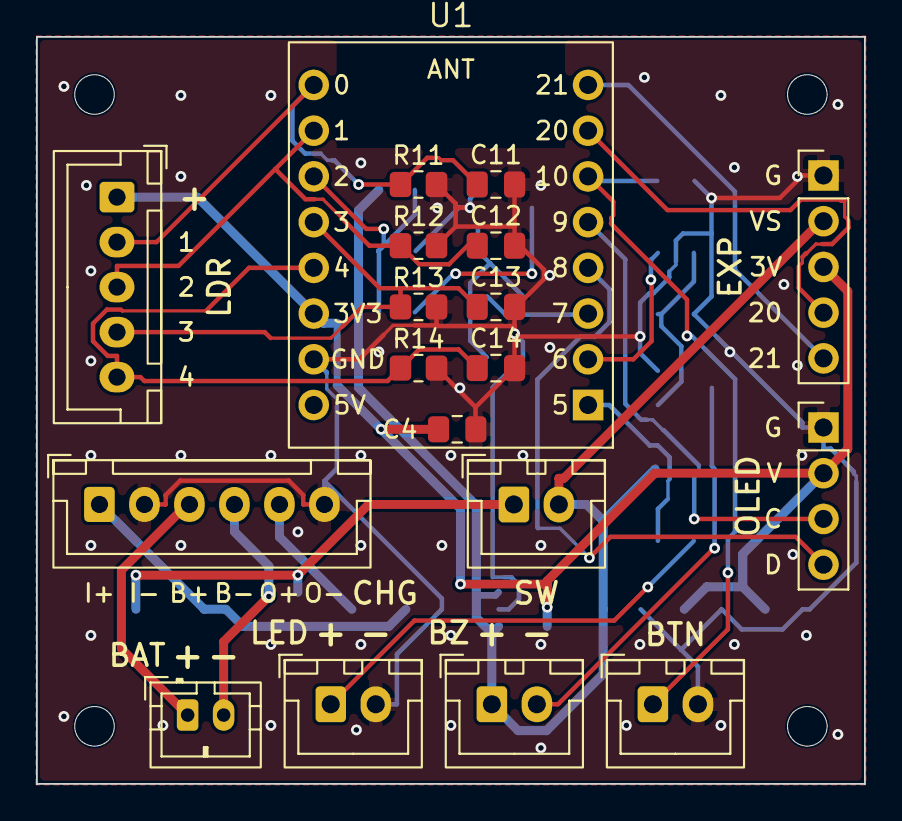
[picture p29: board ivflow.kicad_pcb from above]

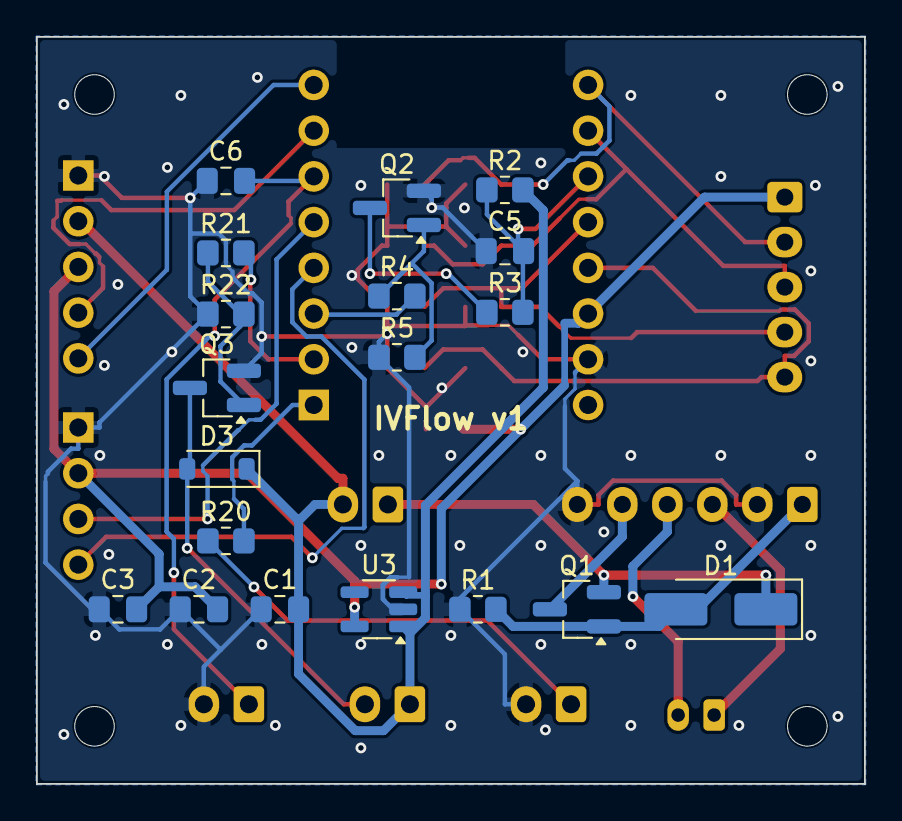
[picture p30: board ivflow.kicad_pcb from below]

Board: 2 copper layers, 46.0 x 41.5 mm, 42 parts (19 on the bottom side), 26 nets.

Other parts of the board:
H1, H2, H3, H4: MountingHole_2.2mm_M2
