Balvinder123x/ivflow-pcb/(commit log)

2026-10-31 Stage 0: environment check and project skeleton
    - KiCad 10.0.8 project ivflow/ivflow.kicad_pro with empty A4 schematic
    and 2-layer 1.6 mm board
    - Project-local library ivflow_lib registered in sym/fp lib tables
    - scripts/make_skeleton.py (non-destructive generator)
    - CLAUDE.md spec, PROGRESS.md, .gitignore
    [ivflow.kicad_pcb, ivflow.kicad_sch]
2026-10-31 Stage 1 (partial): SuperMini + TP4056 symbols, draft SuperMini footprint
    - scripts/make_library.py: kiutils symbols (normalised with kicad-cli),
    pcbnew-generated footprints
    - ESP32-C3_SuperMini footprint is an UNVERIFIED draft from published values
    - TP4056 footprint pending measurements
    - Spec: OLED on fixed-order header, LED moved off-board to J_LED (JST-XH 2)
    [make_library.py]
2026-10-31 Stage 2: schematic on one A4 sheet, ERC clean
    - scripts/make_schematic.py places every part with an explicit net per
    pin, verifies all 110 pin connections against KiCad's netlist, runs ERC
    - scripts/kisexpr.py: lossless S-expression reader/writer, flattens
    derived official symbols for embedding
    - SuperMini pin order corrected from the user's board diagram (power row
    on the right in top view)
    - TP4056 symbol: hidden fields moved off the body
    - ERC: 0 errors, 1 expected warning (TP4056 footprint pending)
    - Includes KiCad's own format upgrade of the project file
    [ivflow.kicad_sch]
2026-11-01 Stage 3: footprints + BOM; power switch, buzzer, button on connectors
    - SW1/BZ1/SW2 replaced by JST-XH 2-pin connectors J6 POWER SW, J7 BUZZER,
    J8 BUTTON (user decision); D3 and C6 stay on the board
    - Footprint and LCSC field assigned to every part (hand-solder pad variants)
    - scripts/make_bom.py exports ivflow/bom/ivflow_bom.csv from the schematic
    and writes the off-board parts list
    - Netlist check 110/110, ERC 0 errors / 1 warning (TP4056 footprint pending)
    [ivflow.kicad_sch, ivflow_bom.csv, ivflow_offboard.csv]
2026-11-01 PROGRESS: correct the connector mis-plug note
2026-11-01 Connector silkscreen labels (applied to footprints in Stage 4)
    Each connector gets a title naming the part that plugs in and a label at
    every pin; polarity signs are drawn large. Preview in docs/.
2026-11-01 Stage 1: provisional module footprints (unverified dimensions marked)
    - SuperMini: row spacing confirmed (5 empty holes), ~2 mm USB-C overhang
    in the courtyard; first-pin offset still unmeasured, marked PROVISIONAL
    - TP4056: outline-only placeholder (17 x 28 mm, USB-C end), no pads until
    the real module is measured; mounted as a removable daughterboard
    - No final placement or fab outputs until both footprints are verified
    - ERC: 0 errors, 0 warnings
    [make_library.py]
2026-11-01 Add shopping list (modules, PCB parts, plug-in parts, cables, hardware)
    [ivflow_offboard.csv]
2026-11-01 TP4056 off-board on J9 (6-pin JST-XH); SuperMini from published dimensions
    - New J9 CHARGER (B6B-XH-A, C144397): 1 IN+, 2 IN-, 3 B+, 4 B-, 5 OUT+,
    6 OUT-. U2 kept in schematic and BOM, not on the board; TP4056
    placeholder footprint removed (module layouts differ between sellers)
    - SuperMini footprint marked as published dimensions, pins assumed centred
    - J9 silk labels (pin names turned 90 deg where wider than the pitch)
    - Shopping list and off-board list updated (6-pin cable, standard 2x8
    SuperMini)
    - Netlist check 116/116, ERC 0 errors / 0 warnings
    [ivflow.kicad_sch, ivflow_bom.csv, ivflow_offboard.csv]
2026-11-02 Stage 4: board outline, M2 holes and component placement (no tracks)
    - scripts/make_board.py builds the board from the schematic netlist
    (footprints, nets, UUID links, fields), places parts from a table,
    adds connector labels, "IVFlow v1", JLCPCB rules and net classes
    - 61 x 52 mm, 4 x M2 corner holes; SuperMini antenna at the top edge,
    LDR filters under the module next to GPIO0-4, USB-C plug path kept SMD-only
    - SuperMini footprint: courtyard on the socket strips only, antenna keepout
    blocks parts, pin names 1.0 mm and centred
    - DRC with schematic parity: 0 violations, 84 unconnected pads (no tracks yet)
    [ivflow.kicad_pcb]
2026-11-02 Stage 5: autorouted with Freerouting, GND pours and stitching vias, DRC clean
    - scripts/route_board.py: DSN export, Freerouting 2.5.0 (jar on a portable
    Java 25 runtime in tools/, git-ignored), session import, GND zones on both
    layers, 94 stitching vias on a 5 mm grid where both pours are solid
    - 100 % routed, 14 signal vias; power 0.5 mm, signals 0.25 mm
    - Antenna keepout free of copper, tracks and vias
    - DRC with schematic parity: 0 violations, 0 unconnected, 0 footprint errors
    [ivflow.kicad_pcb]
2026-11-02 Stage 6: fab outputs for JLCPCB (Gerbers, drill, BOM, CPL, PDFs, renders)
    - scripts/make_fab.py: refuses to run unless ERC and DRC are clean, then
    writes fab/: Gerbers + Excellon drill (zipped for upload), JLCPCB BOM and
    full BOM, pick-and-place CSV, schematic PDF, 1:1 assembly drawing,
    3D renders top/bottom
    - fab/README.md: pre-order SuperMini check and JLCPCB order settings
    [ivflow-B_Cu.gbl, ivflow-B_Mask.gbs, ivflow-B_Paste.gbp, ivflow-B_Silkscreen.gbo, ivflow-Edge_Cuts.gm1, ivflow-F_Cu.gtl, ivflow-F_Mask.gts, ivflow-F_Paste.gtp]
2026-11-02 PROGRESS: drop sensing notes (LED + LDR validated by DripOMeter, tuning R11-R14/C11-C14)
2026-11-05 Compact v1: 46 x 41.5 mm board, parts on both sides, short labels
    - Removed R23/R24 (DNP I2C pull-ups; the OLED module has them)
    - Board shrunk from 61 x 52 to 46 x 41.5 mm: connectors + SuperMini + LDR
    filters on top, power path, battery sense and drivers on the bottom
    - Silk labels: one short name + pin marks (BAT, LDR, LED, BZ, BTN, SW, CHG,
    OLED, EXP); J-numbers moved to the fab layer
    - Rerouted with Freerouting, GND pours + stitching vias; min thermal spokes 1
    - ERC 0/0, DRC 0 violations / 0 unconnected / 0 footprint errors; fab
    outputs, BOM and shopping list regenerated
    - Scripts: explicit PCB_IO plugin for footprint loads, board.Delete() instead
    of Remove(); make_fab keeps fab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
    [ivflow-B_Cu.gbl, ivflow-B_Mask.gbs, ivflow-B_Paste.gbp, ivflow-B_Silkscreen.gbo, ivflow-Edge_Cuts.gm1, ivflow-F_Cu.gtl, ivflow-F_Mask.gts, ivflow-F_Paste.gtp]
2026-11-05 Enclosure plan (clamp + main box) and PCB STEP for fit checks
    [ivflow_pcb.step]
2026-11-05 Enclosure plan: one unit on the chamber, V-channel + hinged light-tight door, colours
2026-11-05 Enclosure plan: sensor geometry from the user's prototype (1 LED, LDR row, 1.2 mm slit)
2026-11-05 Enclosure plan: LDR row confirmed, beam height reference
2026-11-05 Enclosure v1 in Fusion 360: generated by script over the Fusion MCP server
    - scripts/fusion_mcp.py: talks to Fusion's MCP server over HTTP (run scripts,
    screenshots) since the VS Code extension does not load it
    - mech/fusion_enclosure.py: white body (thin lower part, sensor head at the
    top back), black sensor block (V-channel, top fork, tube slot, LED tube,
    LDR pocket + 1.2 x 3 mm slit), black hinged door with magnet pockets, back
    cover; placeholders incl. the real KiCad PCB STEP
    - Interference check: 0 overlaps between 52 bodies
    [fusion_mcp.py]
2026-11-05 Enclosure v2: rounded slim body, smoked acrylic face, sensors fitted from outside
2026-11-05 Enclosure v2: LDR wire hole 4 x 5 mm for the 5-wire bundle
2026-11-05 Enclosure v2: pictures of the LED/LDR pockets and wire holes; capture the PCB position in Fusion
2026-11-05 Enclosure v2: snap latch + light seal on the door, matte pearl white identity
2026-11-05 Enclosure v2: black sensor insert inside the pearl white head (replaces side covers)
2026-11-05 Downloadable files: STL/STEP/acrylic DXF+SVG, buy-and-print guide, release zip
    [ivflow_back_shell_pearl_white.stl, ivflow_chassis_pearl_white.stl, ivflow_door_pearl_white_PETG.stl, ivflow_enclosure_v2_assembly.step, ivflow_face_2mm_smoked_acrylic.dxf, ivflow_sensor_insert_black.stl]
